ngoccamne/DAL_PDU/doc/site/code_architecture/index.html

- Code architecture

# Code architecture

This page describes how the current DAL_PDU firmware is layered, how data moves between modules, and which tasks own which state. It describes the code under PDU/firmware/DAL_PDU/DAL_PDU/. For the short overview see Current firmware architecture; for the scheduler internals see Scheduler design.

## 1. Layers

The source tree is organised in six numbered layers. Lower numbers are closer to the application; the M prefix is only a directory convention, not a build boundary.

Layer | Path | Contents | Depends on
M0 Application | src/dev/M0_App/ | Startup (app_main), console, heartbeat LED, power/TRANS, power monitor, watchdog supervision, Modbus register callbacks | M1, M2, M4
M1 System | src/dev/M1_Sys/ | Scheduler (task and soft-timer service), CommandLine (parser, command table, command handlers), SystemData (shared status records) | M2, M4
M2 Board support | src/dev/M2_BSP/ | Pin map (dal_pdu_board.h), UART ownership, timer ISR, I2C, power GPIO, watchdog pins, LED, Modbus port, TPS55287/PAC1934/24C04 board bindings | M3, M4
M3 Driver | src/dev/M3_Driver/ | Component/ holds the AVR UART, software UART, I2C, and GPIO drivers. Devices/ holds the TPS55287, PAC1934, and 24C04 chip drivers | M4, AVR headers
M4 Middleware | src/dev/M4_MiddleWare/ | Byte FIFO, printf hook, FreeMODBUS (submodule) | AVR headers only

### 1.1 Dependency rules as implemented

The intended direction is strictly downward. The code does not fully keep that promise:

Observed dependency | Where | Assessment
M0 calls M2 directly (power GPIO, TPS55287, PAC1934, watchdog pins) | app_power.c, app_modbus.c, app_power_monitor.c, app_watchdog.c | Expected. M0 is the only caller that sequences the board.
M1 command handlers call M2 BSP | command_tps55287.c, command_pac1934.c, command_i2c.c, command_eeprom.c | Expected for maintenance commands, but it means host tests must mock BSP.
M2 owns the TPS55287 record | bsp_tps55287.c keeps BSP_TPS55287_Status, read by M0 and M1 through BSP_TPS55287_GetStatus() | Resolved 2026-10-06. M2 no longer writes into M1. The record is no longer in SystemData.
M0 Modbus callbacks call M0 app_power and M1 SystemData | app_modbus.c | Expected; both are in the application layer.

Shared state lives in exactly one place. Most of it is in SystemData. The TPS55287 record is in its BSP module, which is the only writer. Commands, tasks, and Modbus callbacks read these records. No layer keeps a second copy of the same fact.

## 2. Module dependency view

flowchart TB
  subgraph M0["M0 Application"]
    MAIN["app_main"]
    CON["app_console"]
    HB["app_heartbeat"]
    PWR["app_power"]
    PMON["app_power_monitor"]
    WDG["app_watchdog"]
    MB["app_modbus"]
  end
  subgraph M1["M1 System"]
    SCH["Scheduler"]
    CMD["CommandLine"]
    SD["SystemData"]
  end
  subgraph M2["M2 Board support"]
    BTIM["bsp_timer"]
    BUART["bsp_uart"]
    BI2C["bsp_i2c"]
    BPWR["bsp_power"]
    BWD["bsp_watchdog"]
    BMB["bsp_modbus"]
    BTPS["bsp_tps55287"]
    BPAC["bsp_pac1934"]
    BEE["bsp_eeprom"]
  end
  subgraph M4["M4 Middleware"]
    FIFO["FIFO"]
    FMB["FreeMODBUS"]
  end

  MAIN --> SCH
  MAIN --> BTIM
  CON --> CMD
  CON --> BUART
  CON --> FIFO
  CON --> WDG
  HB --> SD
  HB --> SCH
  PWR --> SD
  PWR --> BPWR
  PWR --> BTPS
  PMON --> SD
  PMON --> BPAC
  WDG --> SD
  WDG --> BWD
  MB --> FMB
  MB --> SD
  MB --> PWR
  MB --> BTPS
  CMD --> BTPS
  CMD --> BPAC
  CMD --> BI2C
  CMD --> BEE
  CMD --> SD
  BTIM --> SCH
  BTPS --> SD
  BMB --> FMB
  BUART --> FIFO

## 3. Startup sequence

main() calls APP_Main(). Initialization runs with interrupts disabled. Interrupts are enabled only after the scheduler has its task table and Timer0 is running.

sequenceDiagram
  participant M as main
  participant A as APP_Initialize
  participant S as Scheduler
  participant T as Timer0
  participant L as Main loop
  M->>A: APP_Main()
  A->>A: EEPROM init, UART board init, startup banners
  A->>A: SystemData_Init, AppPower_Init, I2C init
  A->>S: SCH_InitializeTaskTable(5 tasks)
  A->>A: Watchdog, console, heartbeat, Modbus init
  A->>A: AppWatchdog_Start (requires all clients registered)
  A->>T: BSP_Timer_Init1ms
  A->>S: SCH_StartScheduler
  A-->>M: true
  M->>M: sei()
  loop forever
    L->>S: SCH_HandleScheduledTask
    L->>L: APP_ModbusTask every 5 ms (AppModbus_Update, two eMBPoll calls)
  end

If any step fails, APP_Initialize closes the UARTs and stops the scheduler, and most failure branches also call BSP_Watchdog_Inhibit(). APP_Main then spins with interrupts disabled. The external TPL5010 watchdog is then the only recovery path, which resets the MCU and retries startup.

## 4. Task inventory

These six tasks are the only scheduled work. Dispatch order is table index order, from app_main.c. All run from the main loop, never from an ISR.

Index | Task | Period | First run (phase) | Reads | Writes
0 | AppConsole_Run | 10 ms | 0 ms | UART0 and console RX FIFOs | Console sessions, response FIFO, TX FIFOs, watchdog check-in; runs one parsed command per call
1 | AppHeartbeat_Update | 20 ms | 0 ms | Operating mode, SystemData heartbeat timing and enable | LED pattern for the mode, soft timer SCH_TIM_LED, watchdog check-in
2 | AppPower_Update | 6 ms | 3 ms | PC4 and PC0 fault inputs, TRANS state | TRANS GPIO and VOUT disable on fault, SystemData power status
3 | AppPowerMonitor_Update | 1000 ms | 0 ms | PAC1934 snapshot | SystemData power monitor status
4 | AppWatchdog_Update | 10 ms | 0 ms | Client check-in times, WAKE pin (PB5) | DONE pin (PB6), wake status, fault latch
5 | AppTemperature_Update | 1000 ms | 0 ms | ADC channel 1 (PF1) through BSP_NTC_ReadTenthsC | SystemData temperature status
6 | APP_ModbusTask (AppModbus_Update) | 5 ms | 0 ms | USART1 RX frame and event queue, SystemData and TPS55287 records through the Modbus callbacks | eMBPoll replies, watchdog check-in

The 6 ms power task and the 10 ms console task are not synchronized; the 3 ms phase keeps the first power check away from the first console pass.

Two more pieces of work run every main-loop pass, outside the table:

- AppModbus_Update() calls eMBPoll() twice, from the 5 ms task. A request needs two polls. This services the USART1 RX/TX event queue and the Modbus callbacks, which read and write SystemData, call AppPower_SetTrans(), and call the TPS55287 BSP.
- The printf hook _putchar writes into the active console response owner, if one is set.

## 5. Data flows

### 5.1 Tick to task

flowchart LR
  T0["Timer0 compare ISR\n1 ms"] --> RT["SCH_RunSystemTickTimer"]
  RT --> EL["Each enabled task:\nelapsed_ms++\nready = TRUE when due"]
  RT --> ST["Soft timers --"]
  ML["Main loop\nSCH_HandleScheduledTask"] --> CL["Read and clear ready\nunder ATOMIC_BLOCK"]
  CL --> RUN["Call task function\nin index order"]

The ISR never calls a task. It only sets ready. A task that is due twice before it runs runs once (see Scheduler design).

### 5.2 Console command

flowchart LR
  RX0["USART0 RX ISR\nUART0 port"] --> RXF["RX FIFO"]
  RXS["Timer2 soft UART\nconsole port"] --> RXF
  RXF --> LINE["AppConsole_ReadSession\nassemble line, echo"]
  LINE --> EX["AppConsole_Execute\nCmdLineProcess"]
  EX --> H["Command handler\nfor one table row"]
  H --> W["Command_OutputString\n-> AppConsole_WriteResponse"]
  W --> RSP["Shared response FIFO\n256 bytes"]
  RSP --> FL["AppConsole_FlushOutput"]
  FL --> TXW["BSP_UART_Write"]
  TXW --> TXF["TX FIFO\nUART0 UDRE ISR or Timer2 ISR"]

Only one port owns the response FIFO at a time, set when a command starts executing. A second port's line waits in its session until the owner finishes sending. help streams one table entry per pass through Command_ContinueOutput, so the 256-byte FIFO can drain between passes.

### 5.3 Modbus request

flowchart LR
  RX1["USART1 RX ISR"] --> PORT["FreeMODBUS port queue"]
  T1["Timer1 compare ISR\nRTU silence"] --> PORT
  PORT --> POLL["eMBPoll in the 5 ms Modbus task"]
  POLL --> CB["eMBReg*CB callbacks\nin app_modbus.c"]
  CB --> SD["SystemData"]
  CB --> PW["AppPower_SetTrans"]
  CB --> TPS["BSP_TPS55287 set/get"]
  POLL --> TX1["USART1 TX ISR\nRS485 direction on PD5"]

### 5.4 Power fault response

1. AppPower_Update runs every 6 ms and reads PC4 and PC0.
2. If either fault is active while TRANS is on, it disables VOUT first, then drops TRANS, and latches the fault in internal EEPROM until it is cleared.
3. It publishes the new status to SystemData. Modbus and console trans get read that record.
4. A console or Modbus request to turn TRANS on re-checks both faults before enabling PC2, and returns TRANS fault if either is still active.

The mode (NORMAL, MANUAL, WARNING, or ERROR) is derived from the self-test, the fault latch, the manual request, and the PAC1934 status. See Mode state machine.

### 5.5 Telemetry

AppPowerMonitor_Update runs once per second. It calls BSP_PAC1934_ReadSnapshot and writes voltage, current, and power for four channels. The pac1934 console command reads the record, and does not trigger a fresh conversion itself. The TPS55287 record is refreshed by BSP calls in the command and Modbus paths, not by a periodic task. It lives in M2, so it is read through BSP_TPS55287_GetStatus().

### 5.6 Watchdog handshake

flowchart LR
  C1["Console task\ncheck-in"] --> WS["Watchdog state\nlast check-in per client"]
  C2["Heartbeat task\ncheck-in"] --> WS
  WS --> WU["AppWatchdog_Update\nevery 10 ms"]
  WU -->|"all clients fresh"| DONE["Pulse DONE high 100 ms\nPB6 to TPL5010"]
  WU -->|"client late or monitor late"| FLT["Fault latch\nstop DONE pulses"]
  FLT --> RST["TPL5010 resets MCU"]

The client timeout is 200 ms for both clients. The monitor timeout is also 200 ms. A fault latch is permanent until reset.

## 6. Shared state and who touches it

State | Owner | Writers | Readers | Concurrency rule
SystemData heartbeat, power, watchdog-wake, PAC1934, temperature records | M1 SystemData | Main-loop tasks, command handlers, Modbus callbacks | Main-loop tasks, commands, Modbus | No ISR touches these records. Single-context access.
TPS55287 record | M2 bsp_tps55287.c | The TPS55287 BSP calls, on the main loop | Main loop, command handlers, Modbus callbacks, AppSetpoint_Update through BSP_TPS55287_GetStatus() | Written only from the main loop. Single-context access.
Software clock | M0 app_clock | Main loop: time, Modbus callbacks (40040–40041), the event log, and a 1 s task that writes the 15-minute checkpoint | Main loop | Written only from the main loop. SCH_SystemTick supplies the elapsed time. Checkpoints go to internal EEPROM at 110–151 (a ring of 8).
Scheduler task table | M1 Scheduler | SCH_RunSystemTickTimer (ISR): elapsed_ms, ready. Main loop: enabled, ready cleared, and period changes | SCH_HandleScheduledTask | Main-loop writes use ATOMIC_BLOCK. ISR writes rely on the ISR being the only writer of elapsed_ms and ready set.
Scheduler soft timers | M1 Scheduler | Main loop (SCH_TIM_Start) and ISR (decrement) | Main loop (SCH_TIM_isCompleted) | Start and read are atomic. Decrement is ISR-only.
UART and console FIFOs | M4 FIFO, M2 UART | UART ISRs, Timer2 ISR, and main-loop writes | Main loop, ISRs | fifo.h states that Push, Pop, Count, and Clear are atomic on AVR. The response spool is used only from the main loop.
Console response spool and session state | M0 app_console | Main loop only | Main loop only | No ISR access.
Modbus port state | FreeMODBUS | USART1 and Timer1 ISRs, then eMBPoll in the 5 ms Modbus task | eMBPoll | Standard FreeMODBUS port contract.

Everything an ISR touches is either a volatile scalar, an atomically-read counter, or a FIFO designed for one producer and one consumer. The main loop owns all application state.

## 7. Known gaps in the architecture

- Priorities. Tasks run in table order. A long task delays every later task in the same pass. Nothing measures execution time. See the scheduler design.
- Layer inversion: resolved. bsp_tps55287.c owns its record, so M2 no longer calls into M1. The record is read through BSP_TPS55287_GetStatus(). The other records are still written by M0 modules, which is the expected direction.
- Command and BSP coupling. Command handlers call BSP directly, so the command tests need the BSP mocked. This is acceptable for maintenance commands but not for future user-facing commands.
- Duplicate overview. Current firmware architecture and this page cover the same layers. Keep the overview short and point it here for detail.

Previous Next

Built with MkDocs (https://www.mkdocs.org/) using a theme (https://github.com/readthedocs/sphinx_rtd_theme) provided by Read the Docs (https://readthedocs.org).

« Previous Next »
