ngoccamne/DAL_PDU/ref/schematic/DAL_PDU.pdf

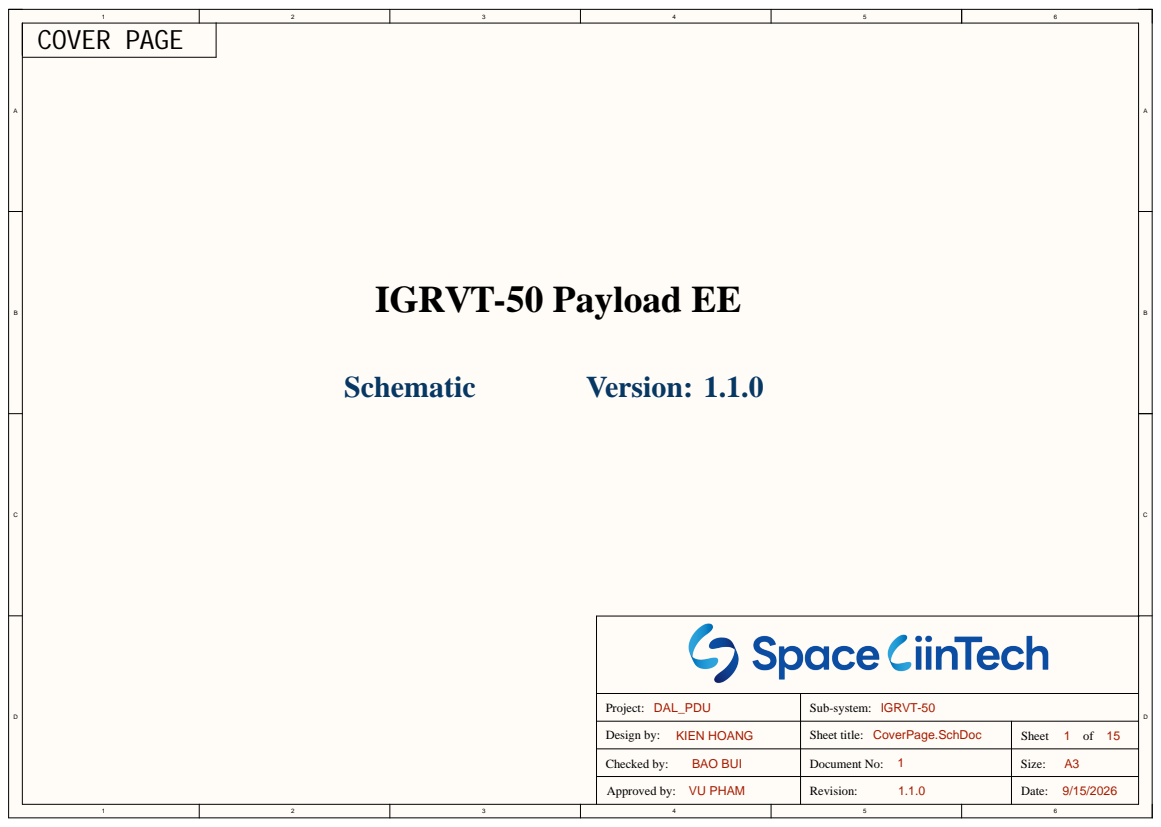
[picture p1: page 1]

Project: DAL_PDU | Sub-system: IGRVT-50

Design by: KIEN HOANG | Sheet title: CoverPage.SchDoc | Sheet 1 of 15

Checked by: BAO BUI | Document No: 1 | Size: A3

Approved by: VU PHAM | 1.1.0 Revision: | Date: 9/15/2026

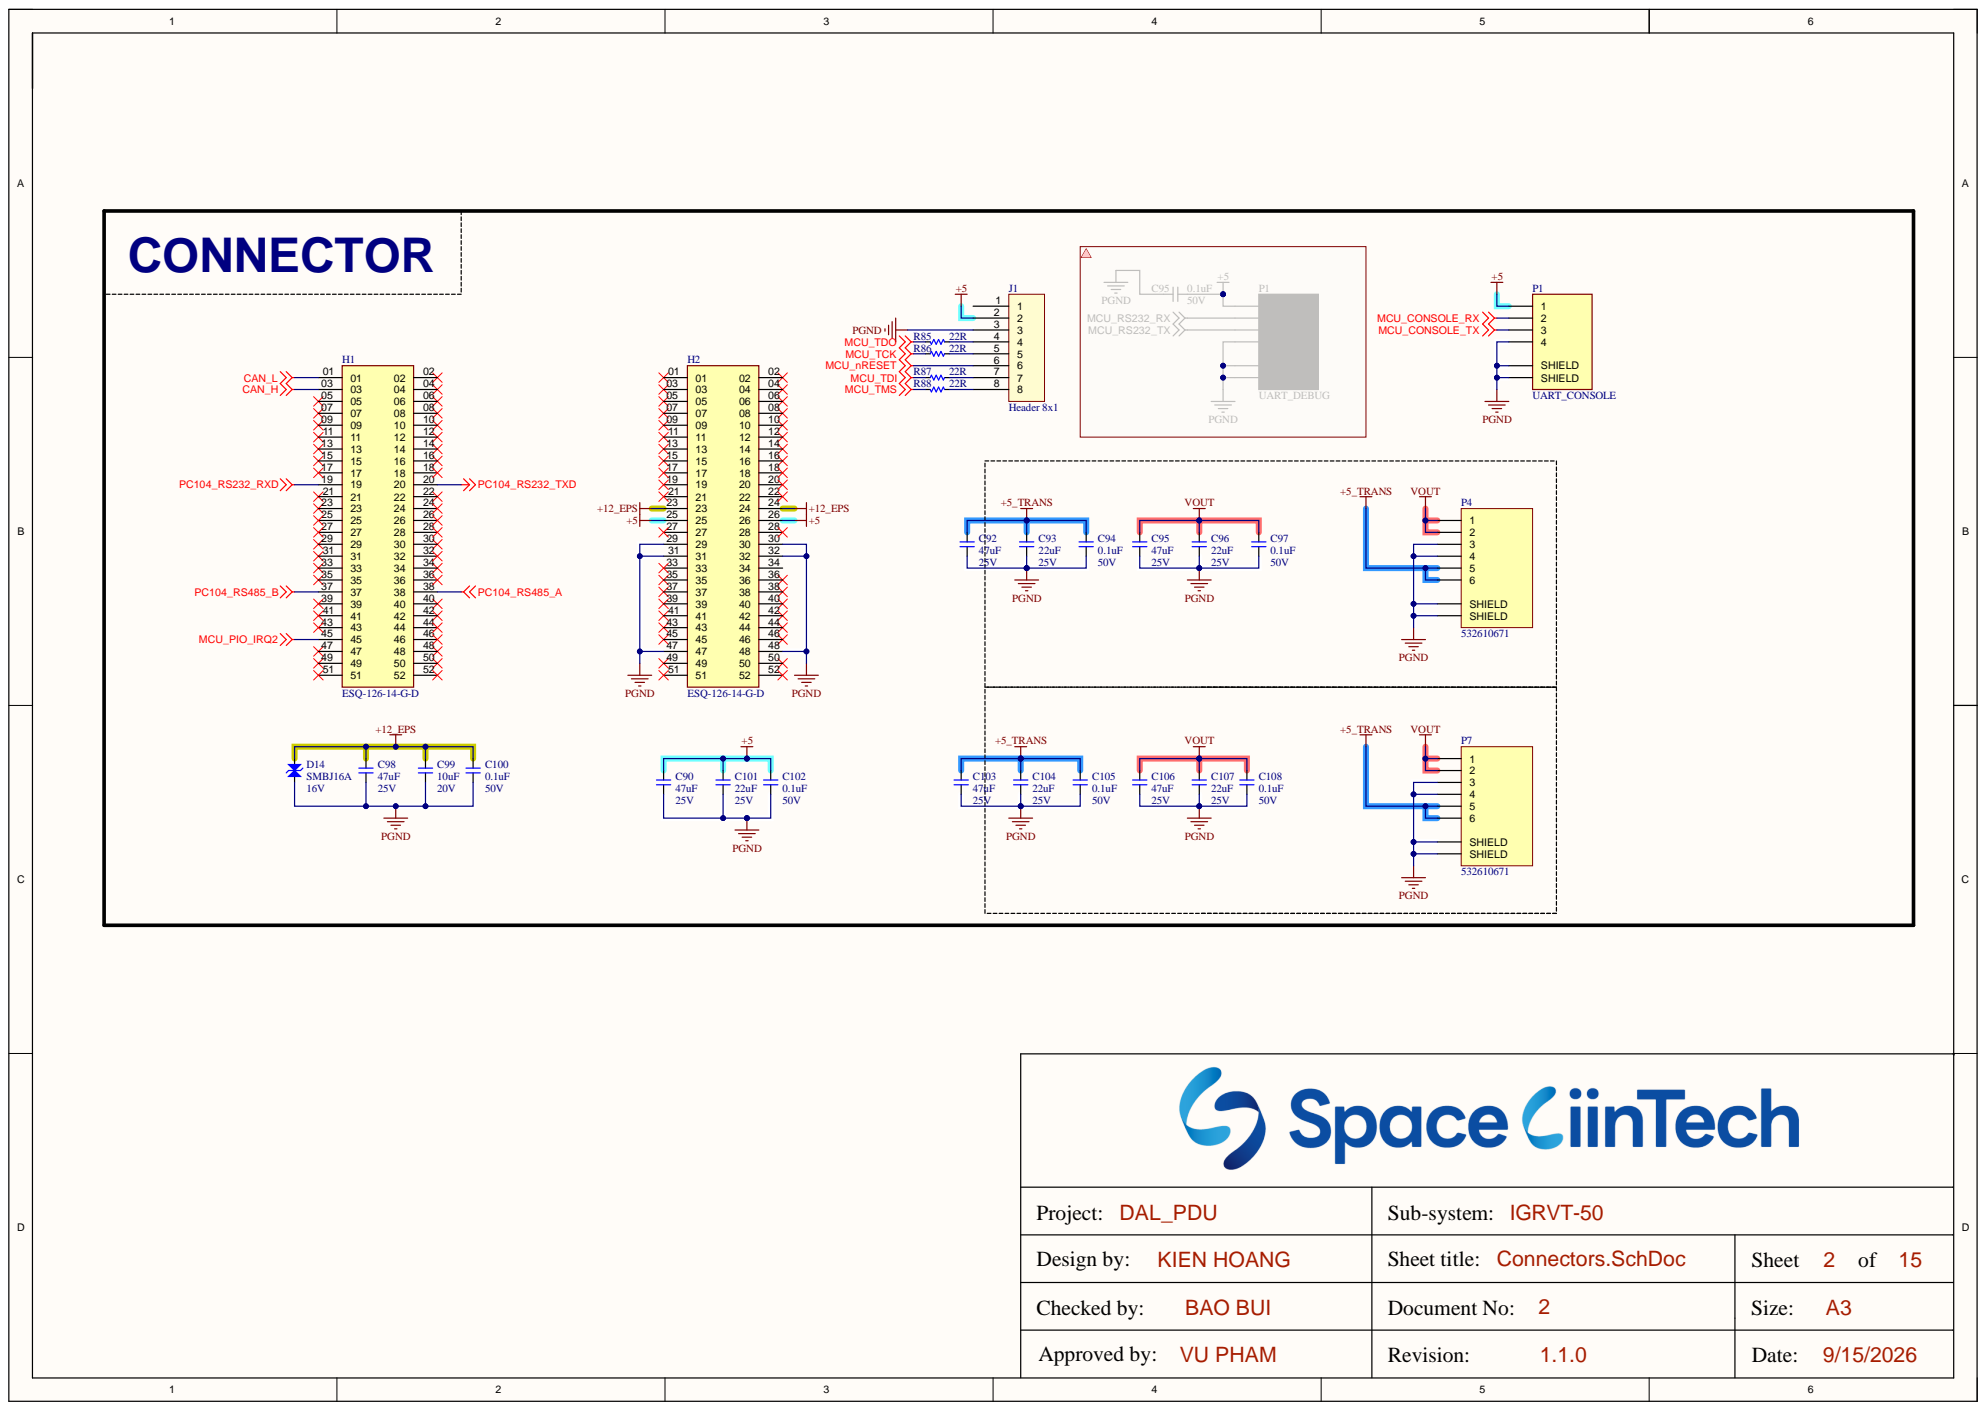
[picture p2: page 2]

Project: DAL_PDU | Sub-system: IGRVT-50

Design by: KIEN HOANG | Sheet title: Connectors.SchDoc | Sheet 2 of 15

Checked by: BAO BUI | Document No: 2 | Size: A3

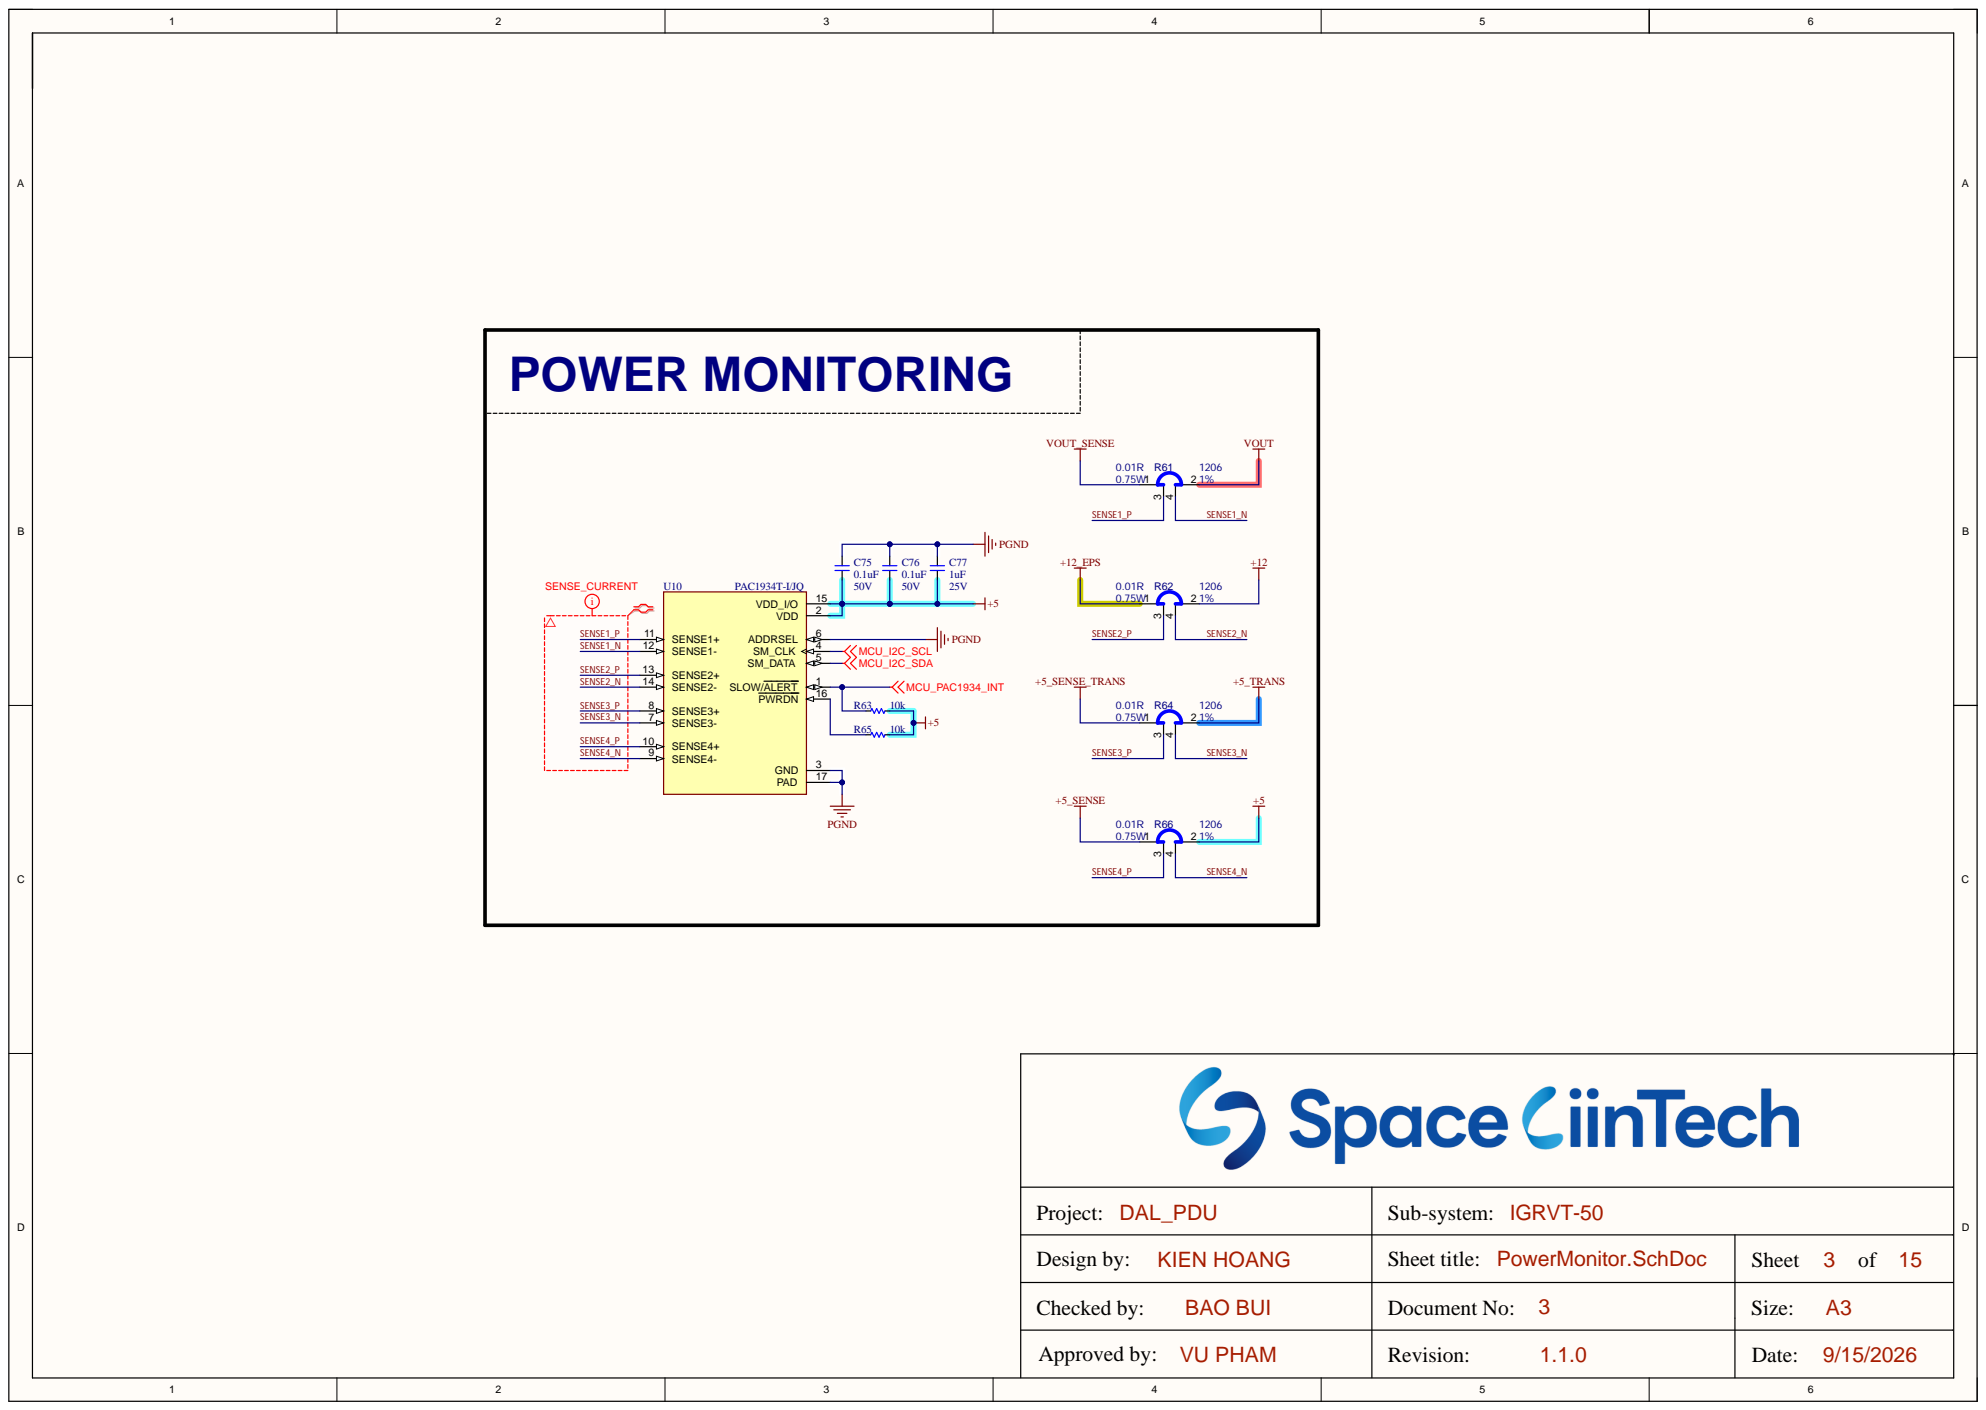
[picture p3: page 3]

Project : DAL_PDU | Sub-system : IGRVT-50

Design by: KIEN HOANG | Sheet title: PowerMonitor.SchDoc | Sheet 3 of 15

Checked by: BAO BUI | Document No: 1.1.0 3 | Size: A3

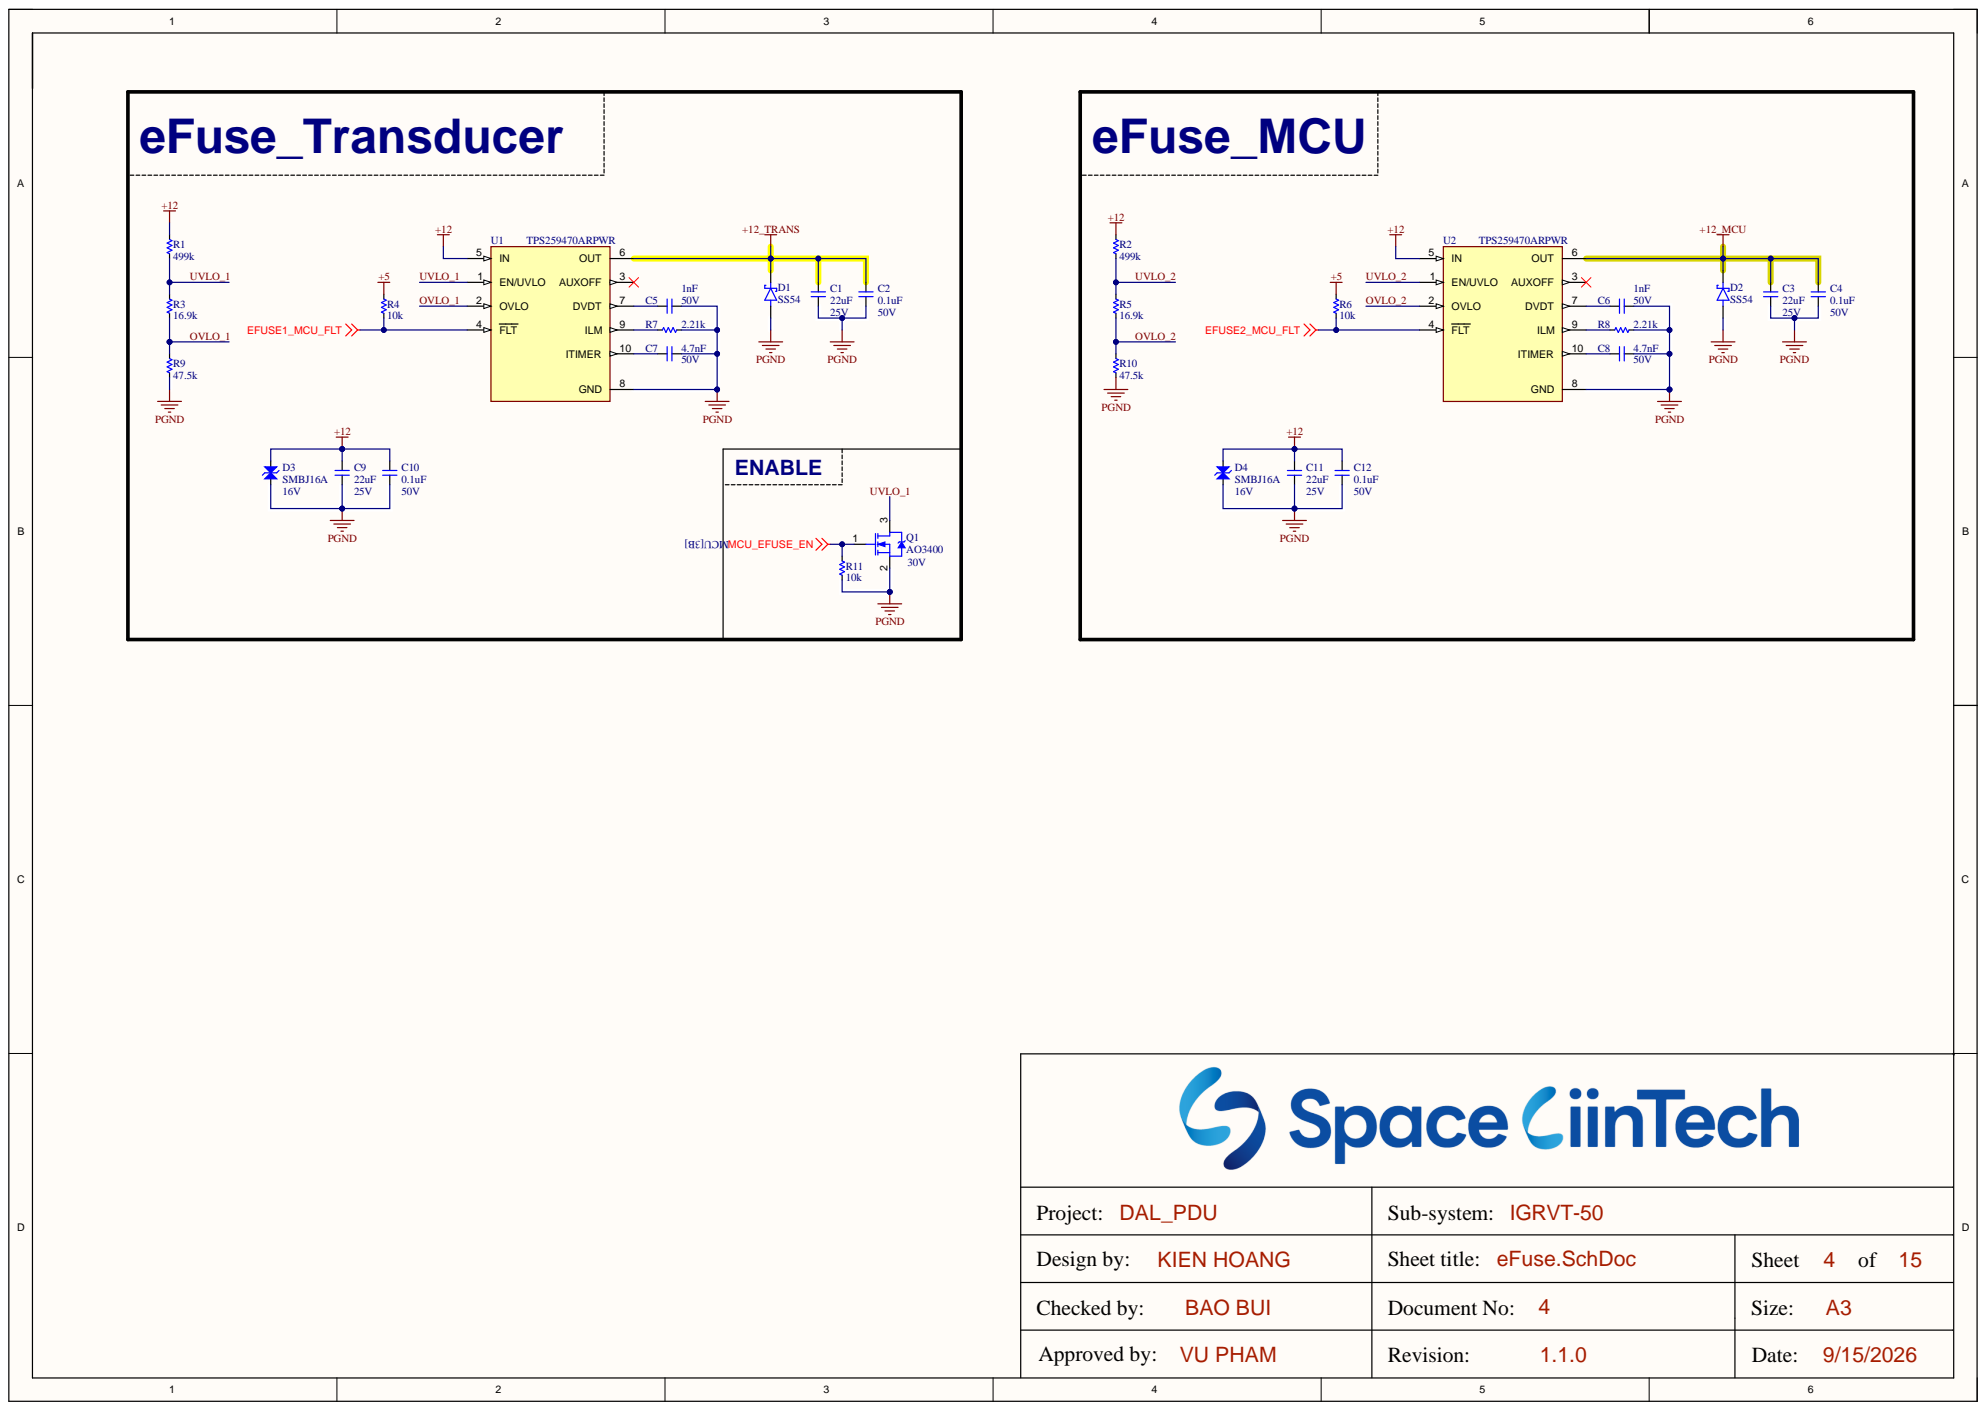
[picture p4: page 4]

Project : DAL_PDU | Sub-system : IGRVT-50

Design by: KIEN HOANG | Sheet title: eFuse.SchDoc | Sheet 4 of 15

Checked by: BAO BUI | Document No: 1.1.0 4 | Size: A3

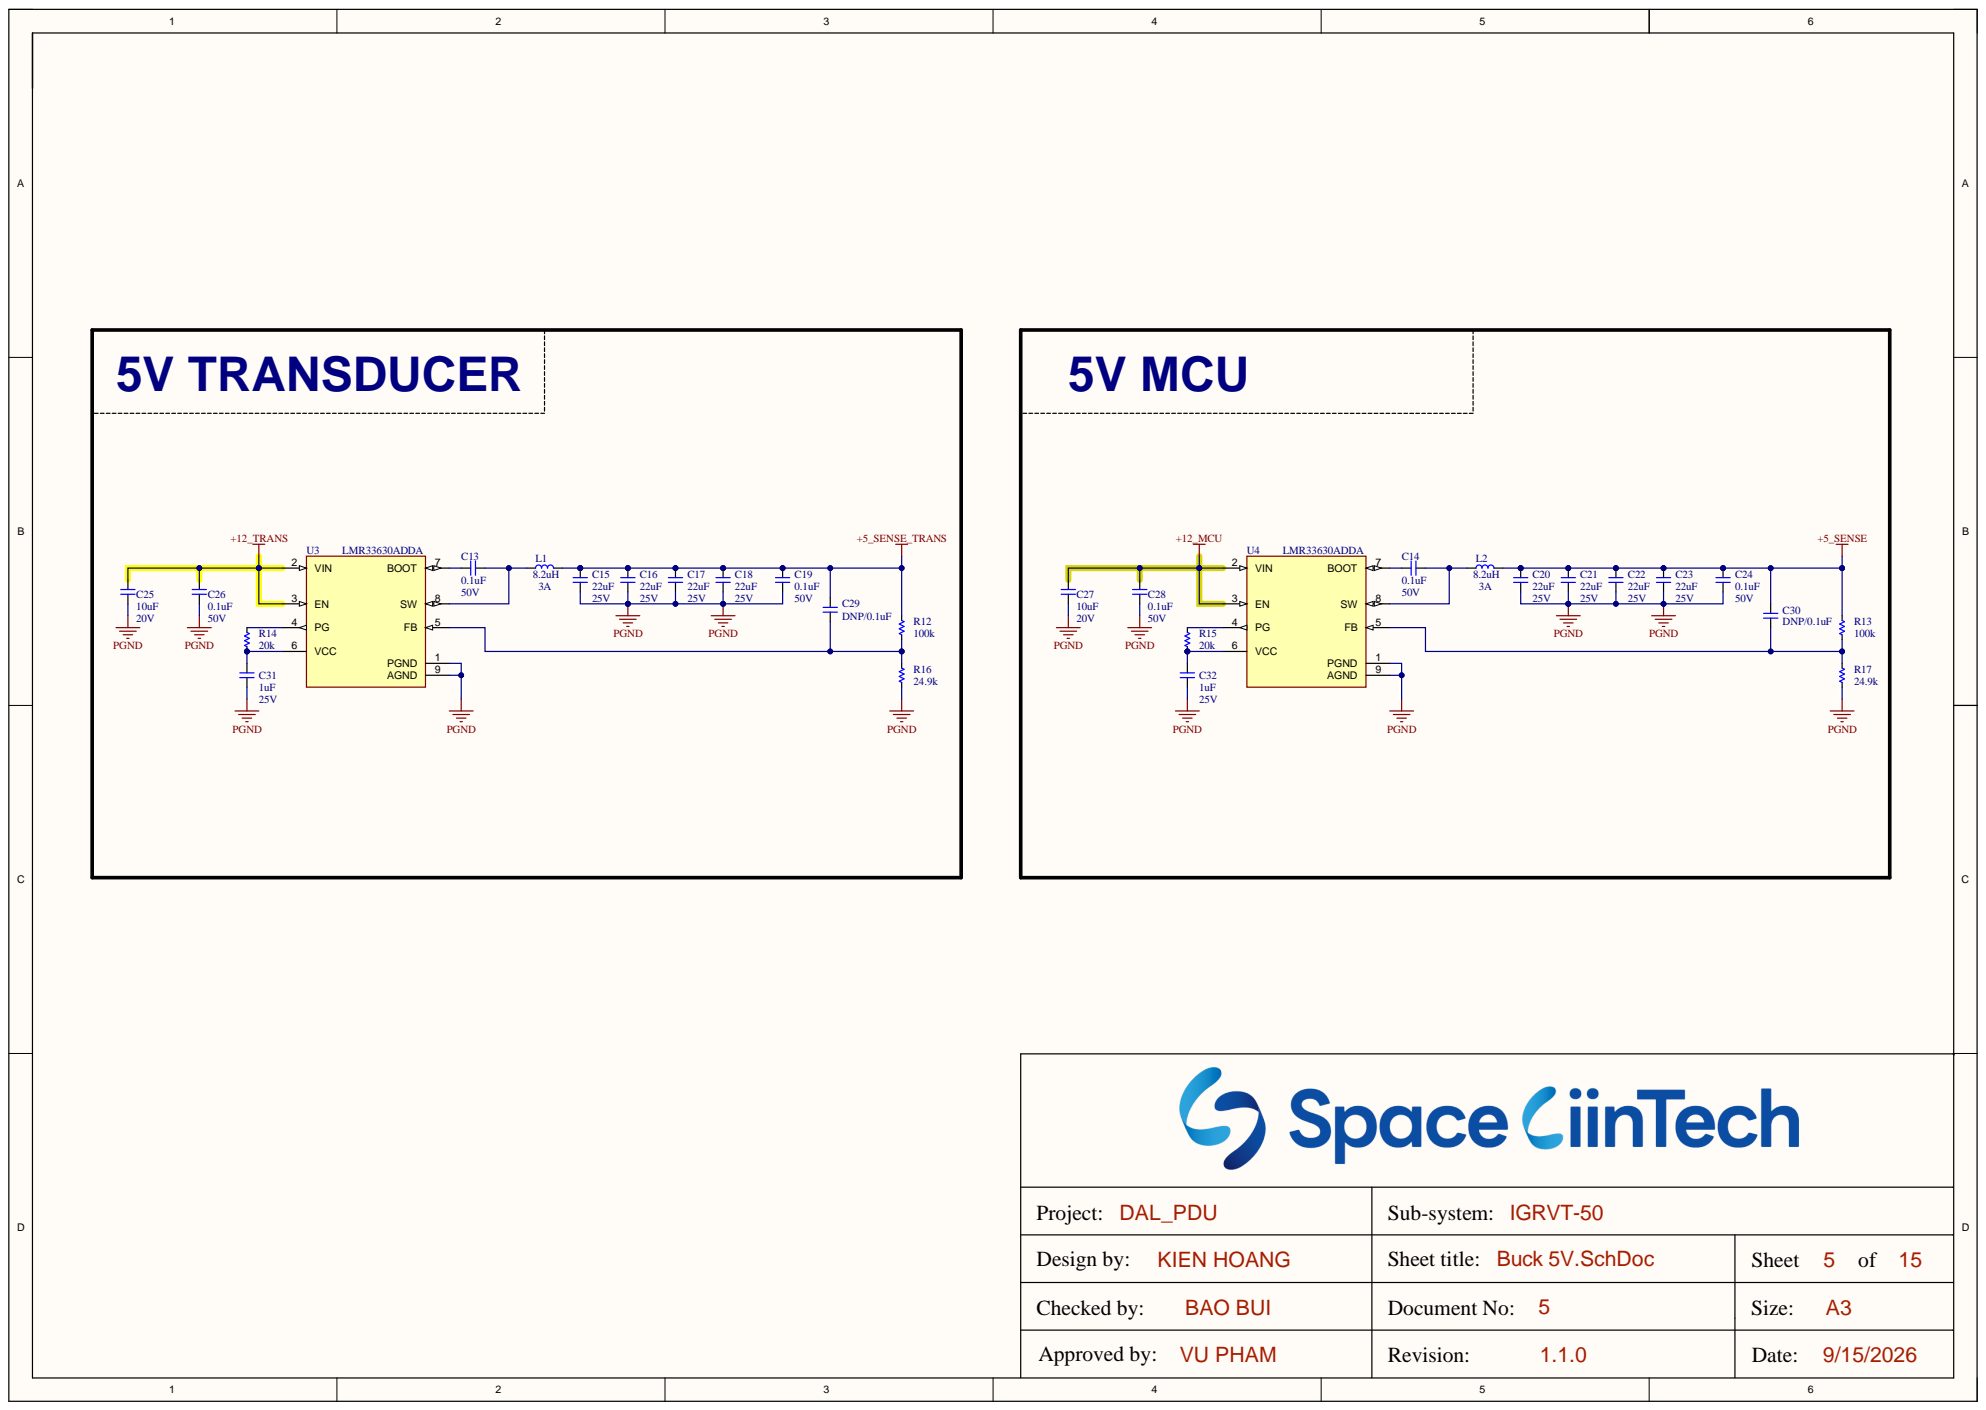
[picture p5: page 5]

Project : DAL_PDU | Sub-system : IGRVT-50

Design by: KIEN HOANG | Sheet title: Buck 5V.SchDoc | Sheet 5 of 15

Checked by: BAO BUI | Document No: 1.1.0 5 | Size: A3

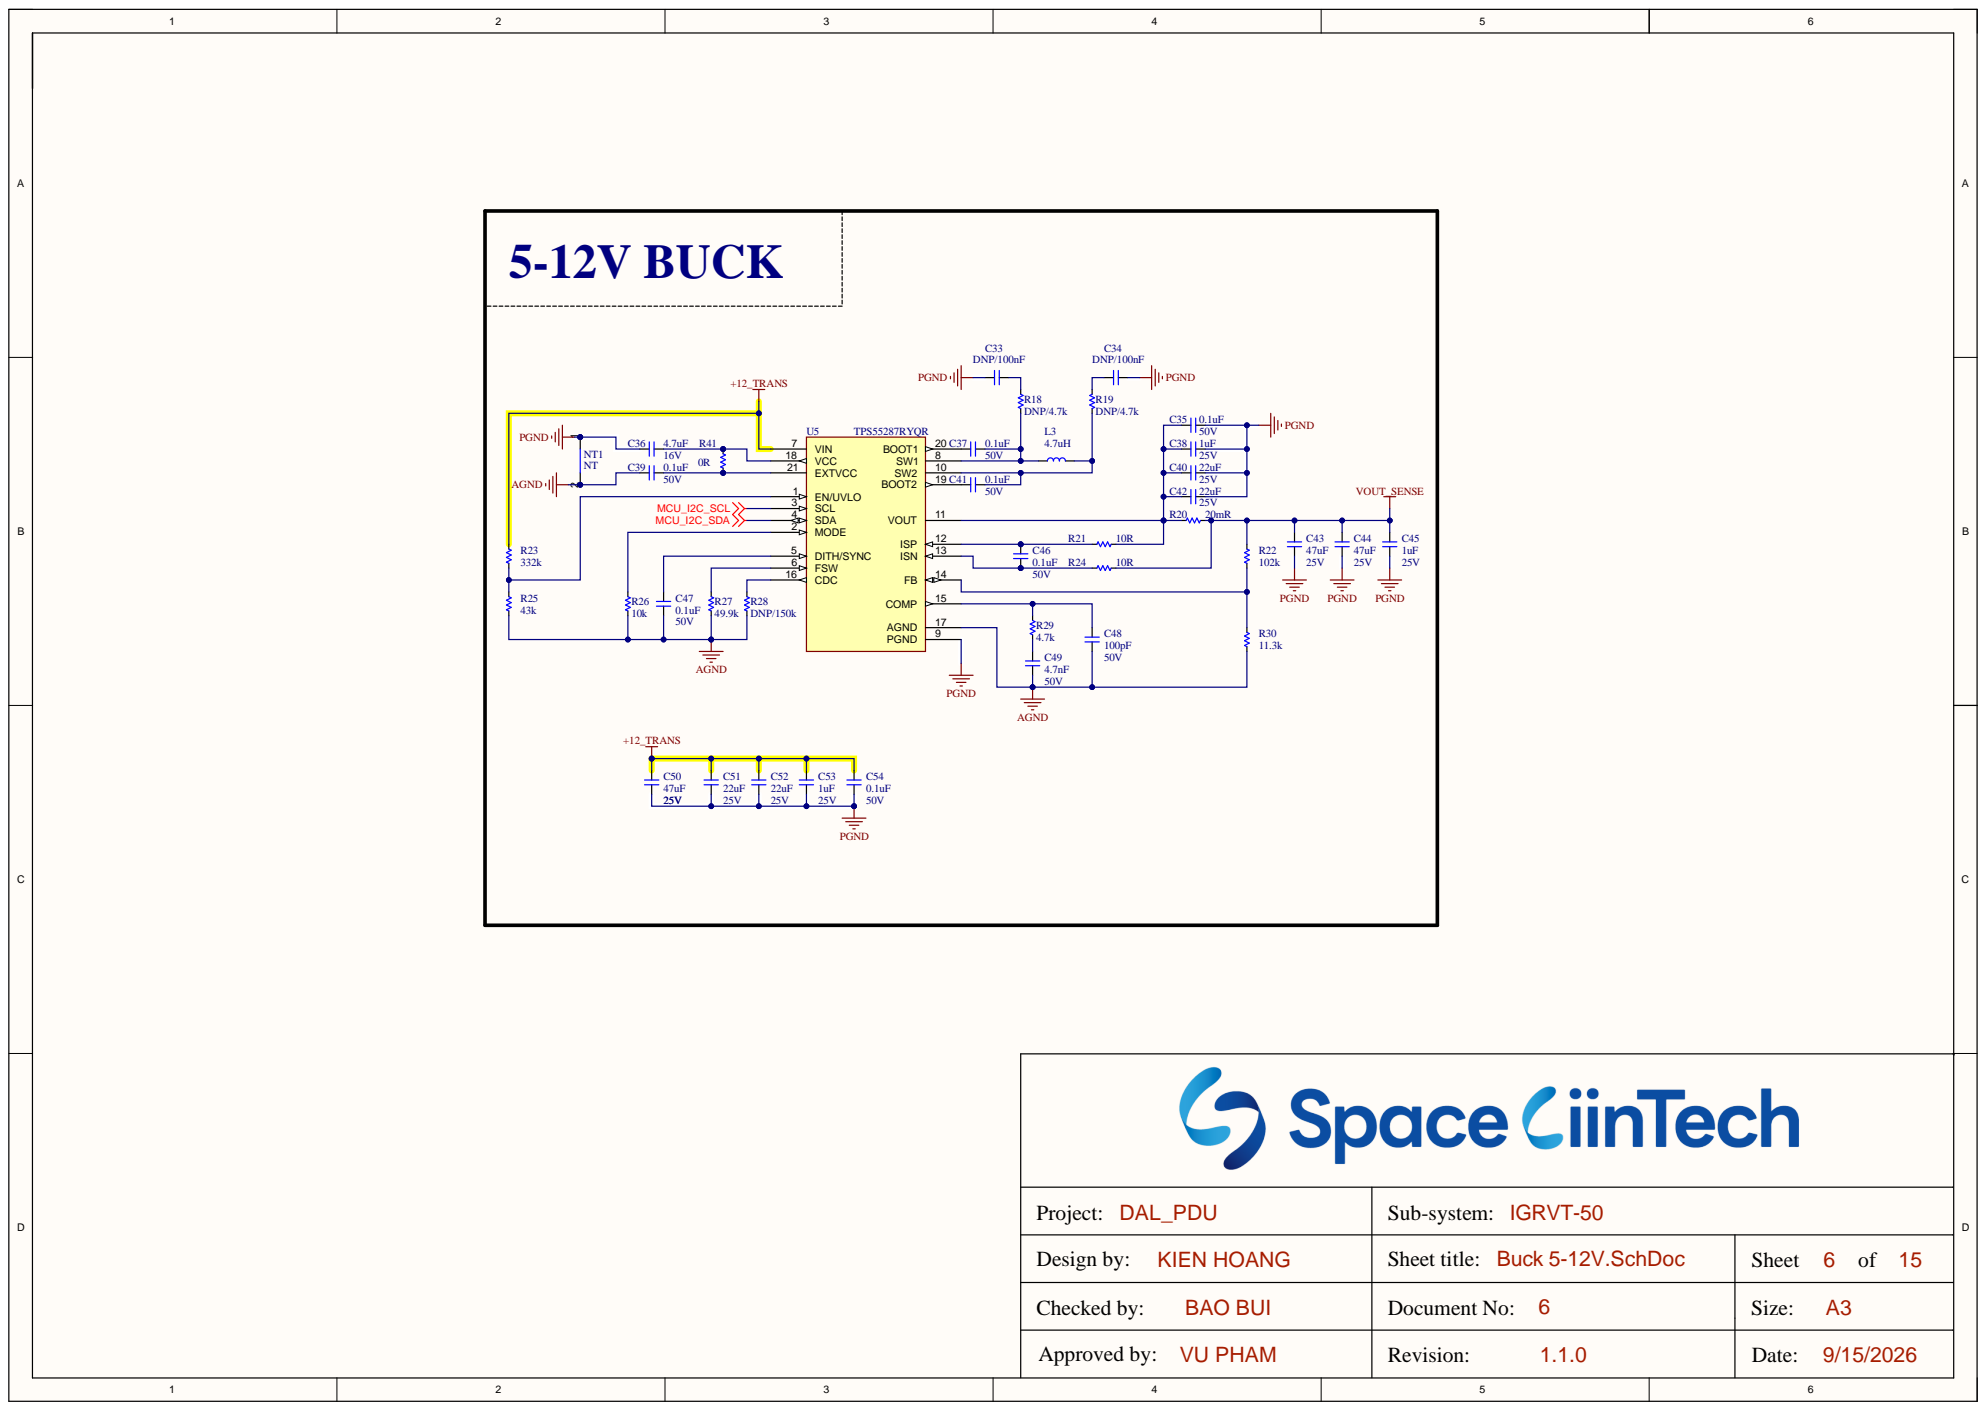
[picture p6: page 6]

DITH/SYNC 5
FSW 6 | 0.1uF R24
CDC 16 | 50V

Project: DAL_PDU | Sub-system: IGRVT-50

Design by: KIEN HOANG | Sheet title: Buck 5-12V.SchDoc | Sheet 6 of 15

Checked by: BAO BUI | Document No: 6 | Size: A3

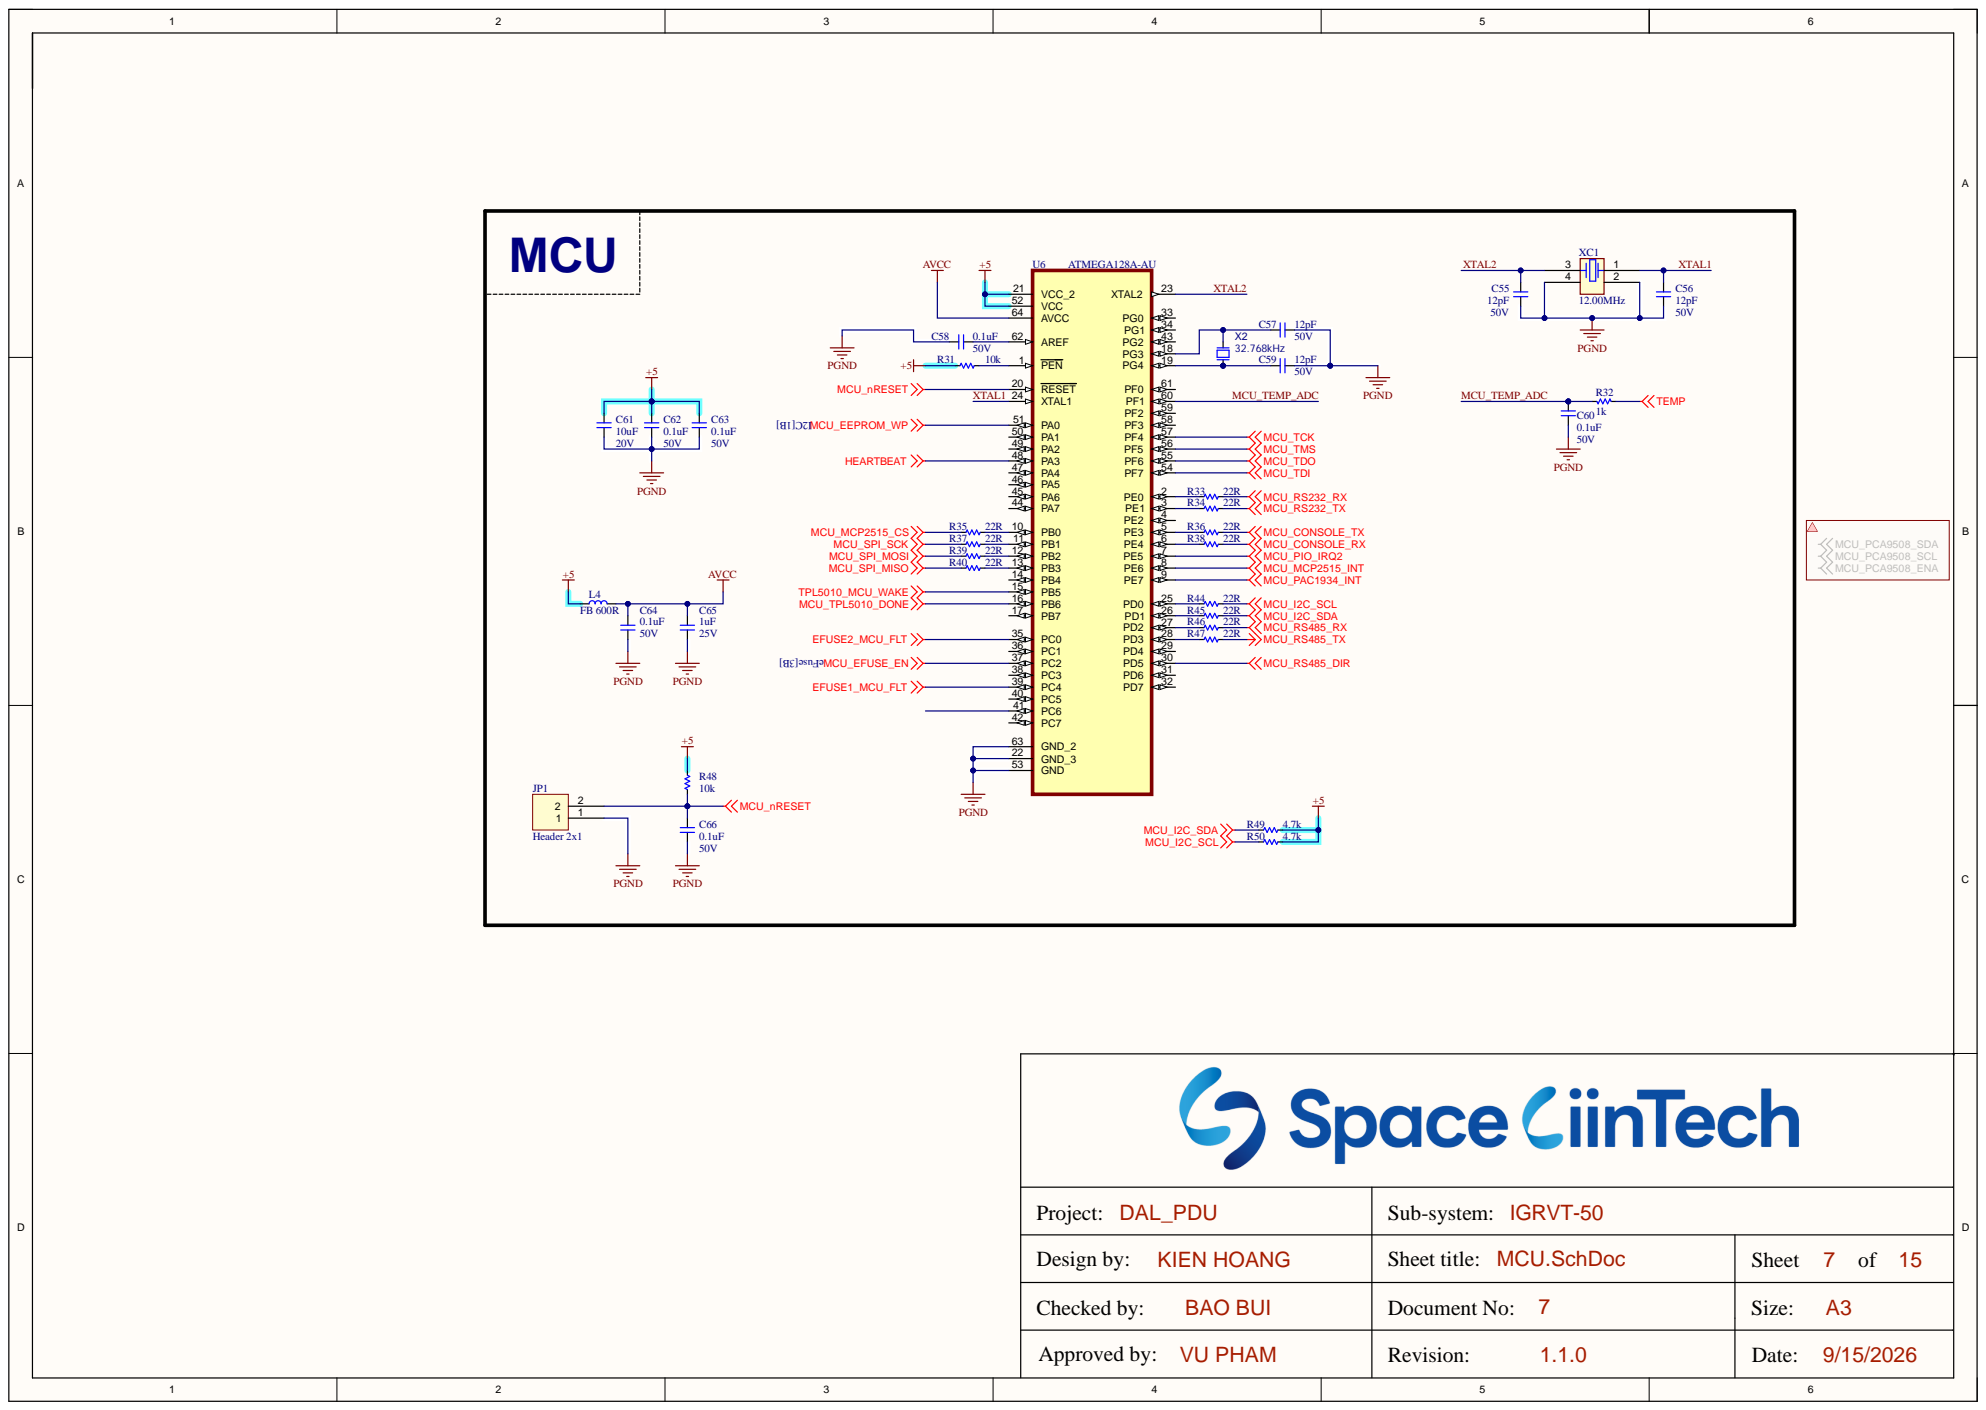
[picture p7: page 7]

2 2
5 3

Project : DAL_PDU | Sub-system : IGRVT-50

Design by: KIEN HOANG | Sheet title: MCU.SchDoc | Sheet 7 of 15

Checked by: BAO BUI | Document No: 1.1.0 7 | Size: A3

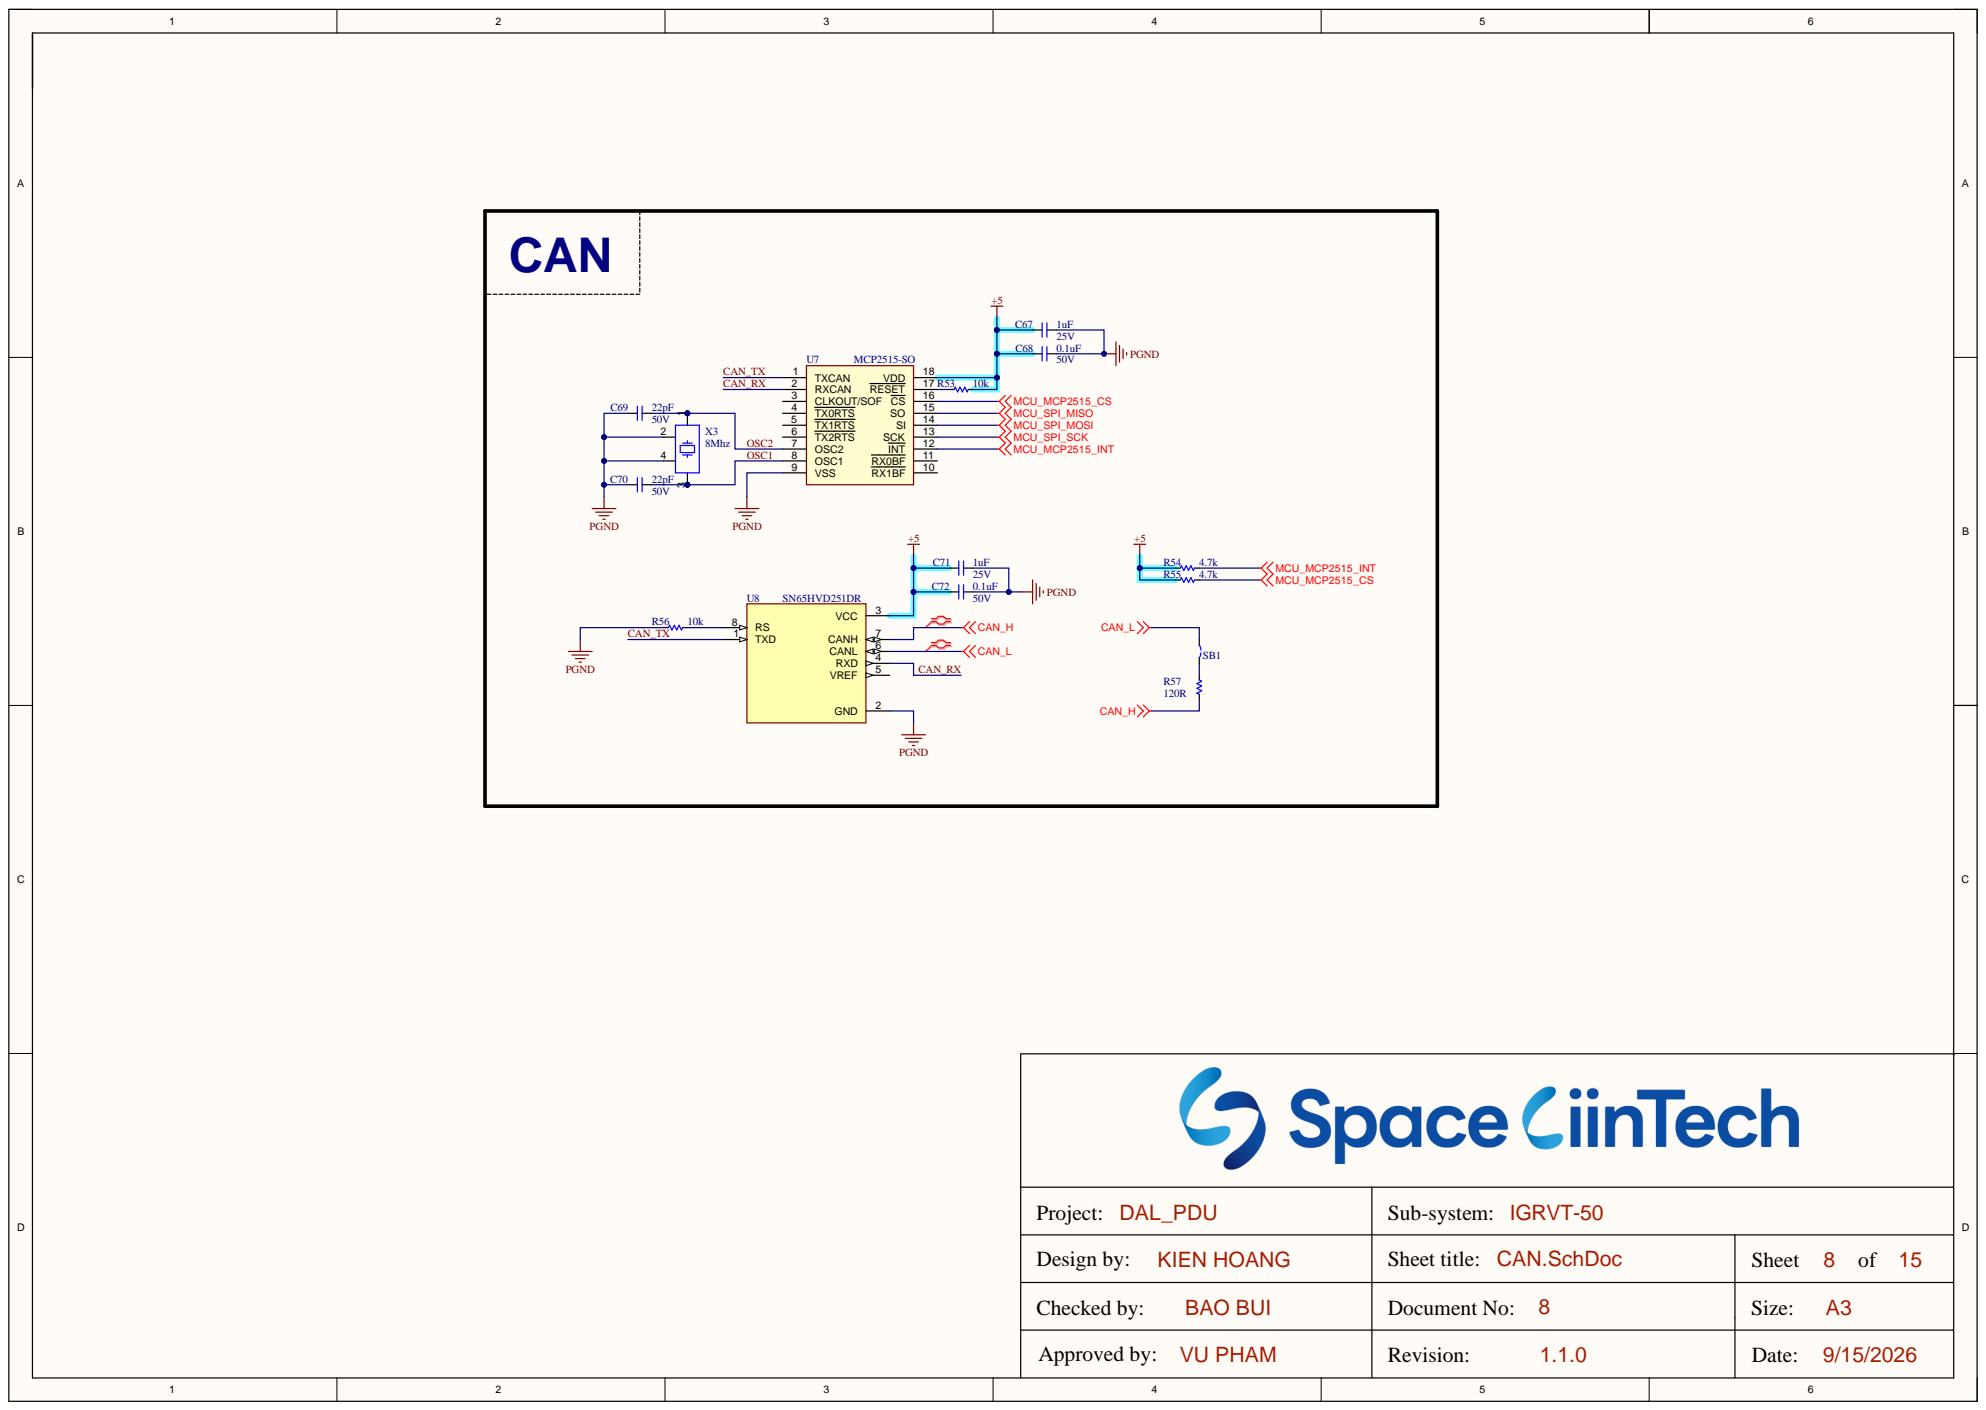
[picture p8: page 8]

Project: DAL_PDU | Sub-system: IGRVT-50

Design by: KIEN HOANG | Sheet title: CAN.SchDoc | Sheet 8 of 15

Checked by: BAO BUI | Document No: 8 | Size: A3

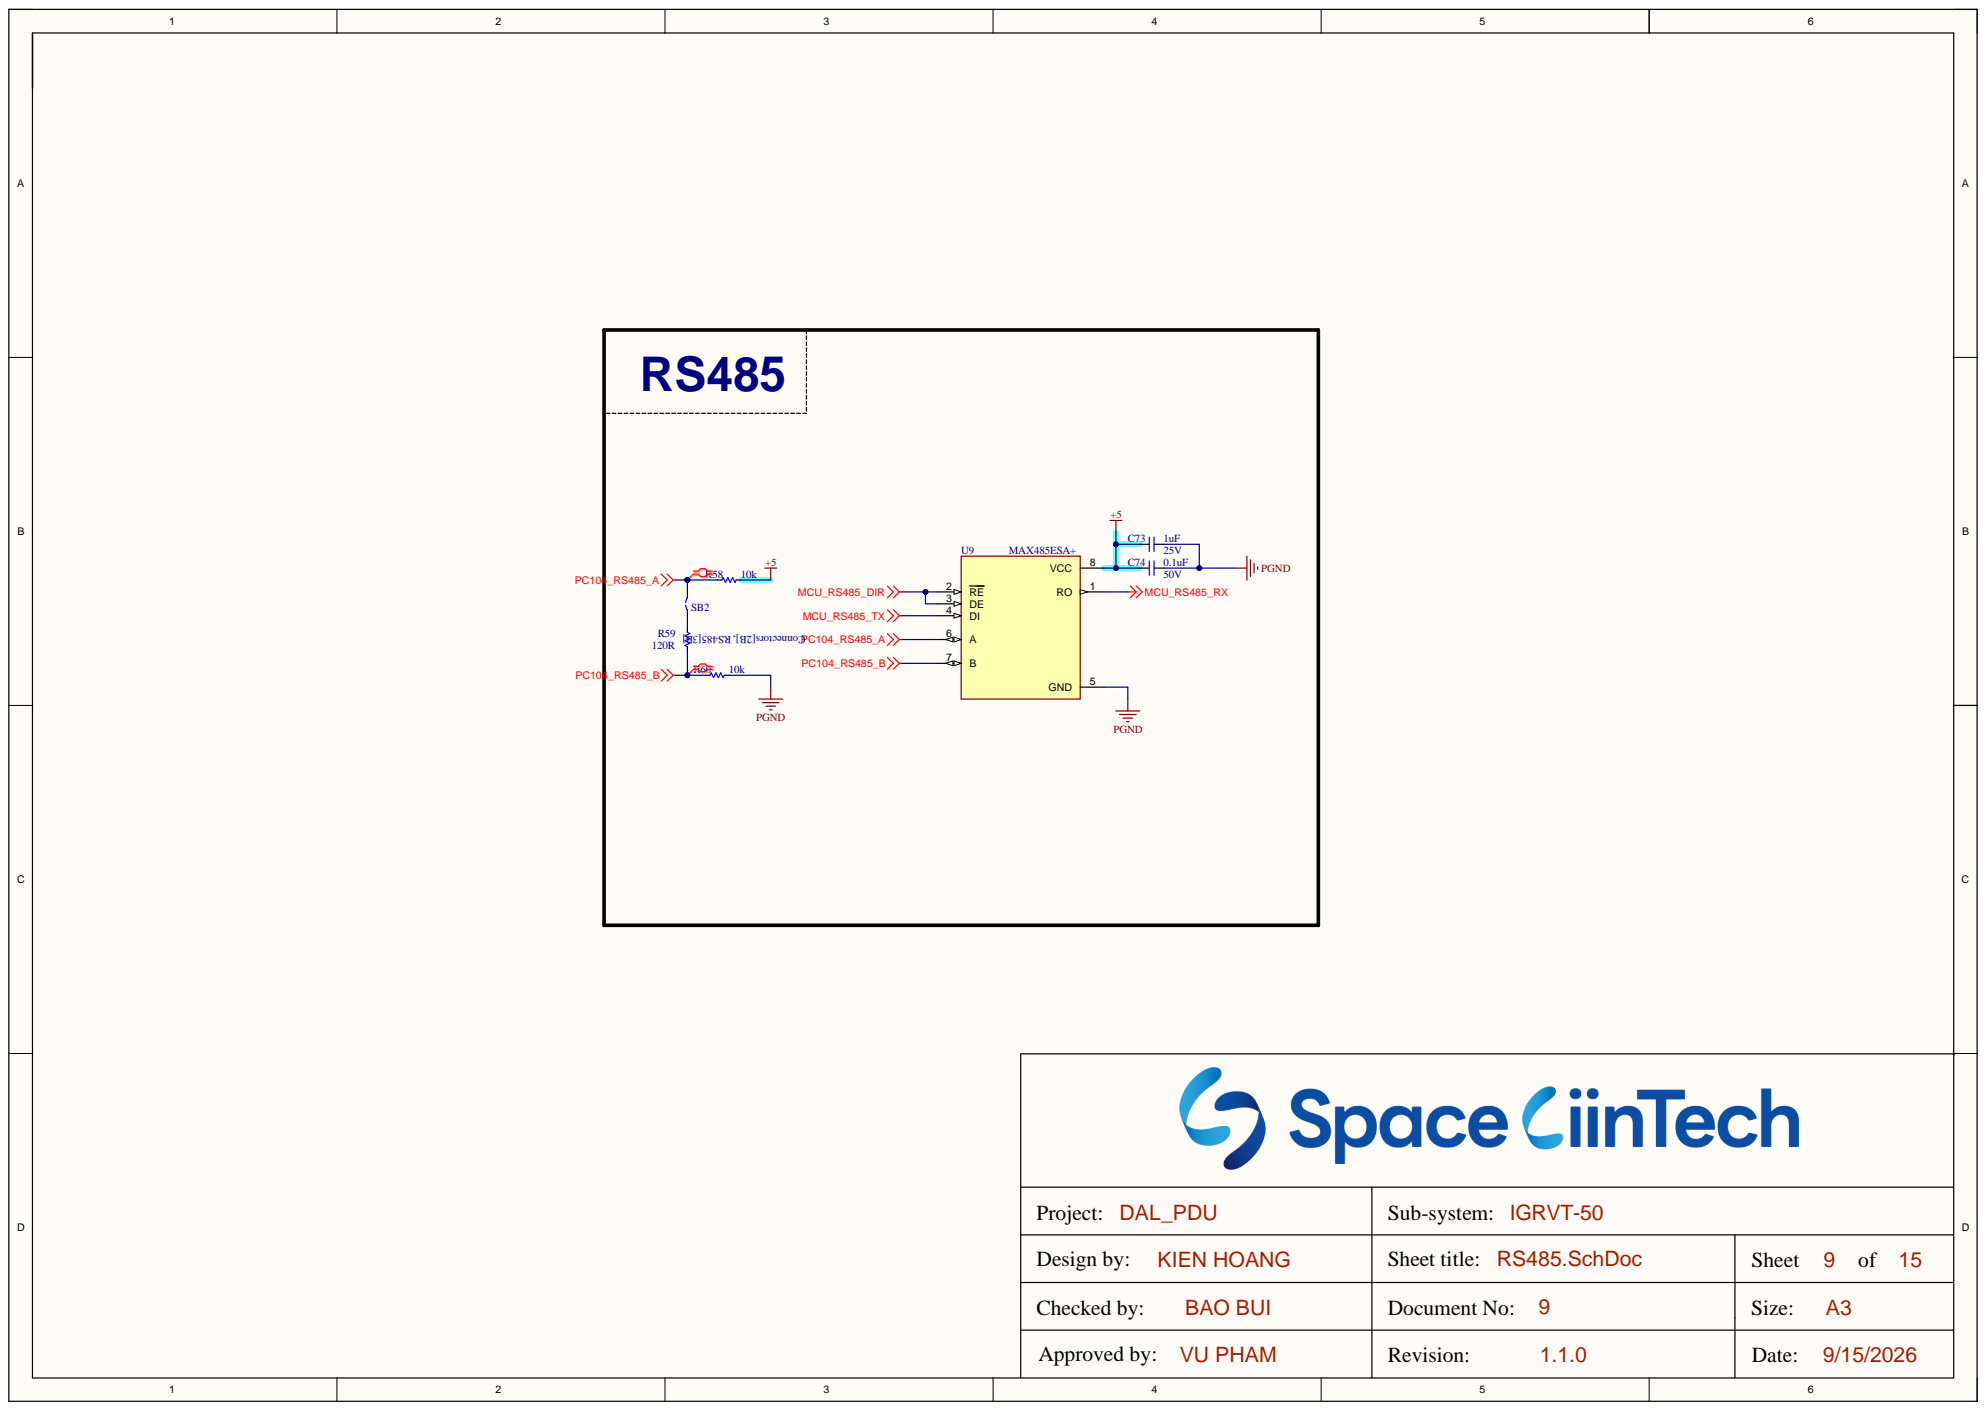
[picture p9: page 9]

Project : DAL_PDU | Sub-system : IGRVT-50

Design by: KIEN HOANG | Sheet title: RS485.SchDoc | Sheet 9 of 15

Checked by: BAO BUI | Document No: 1.1.0 9 | Size: A3

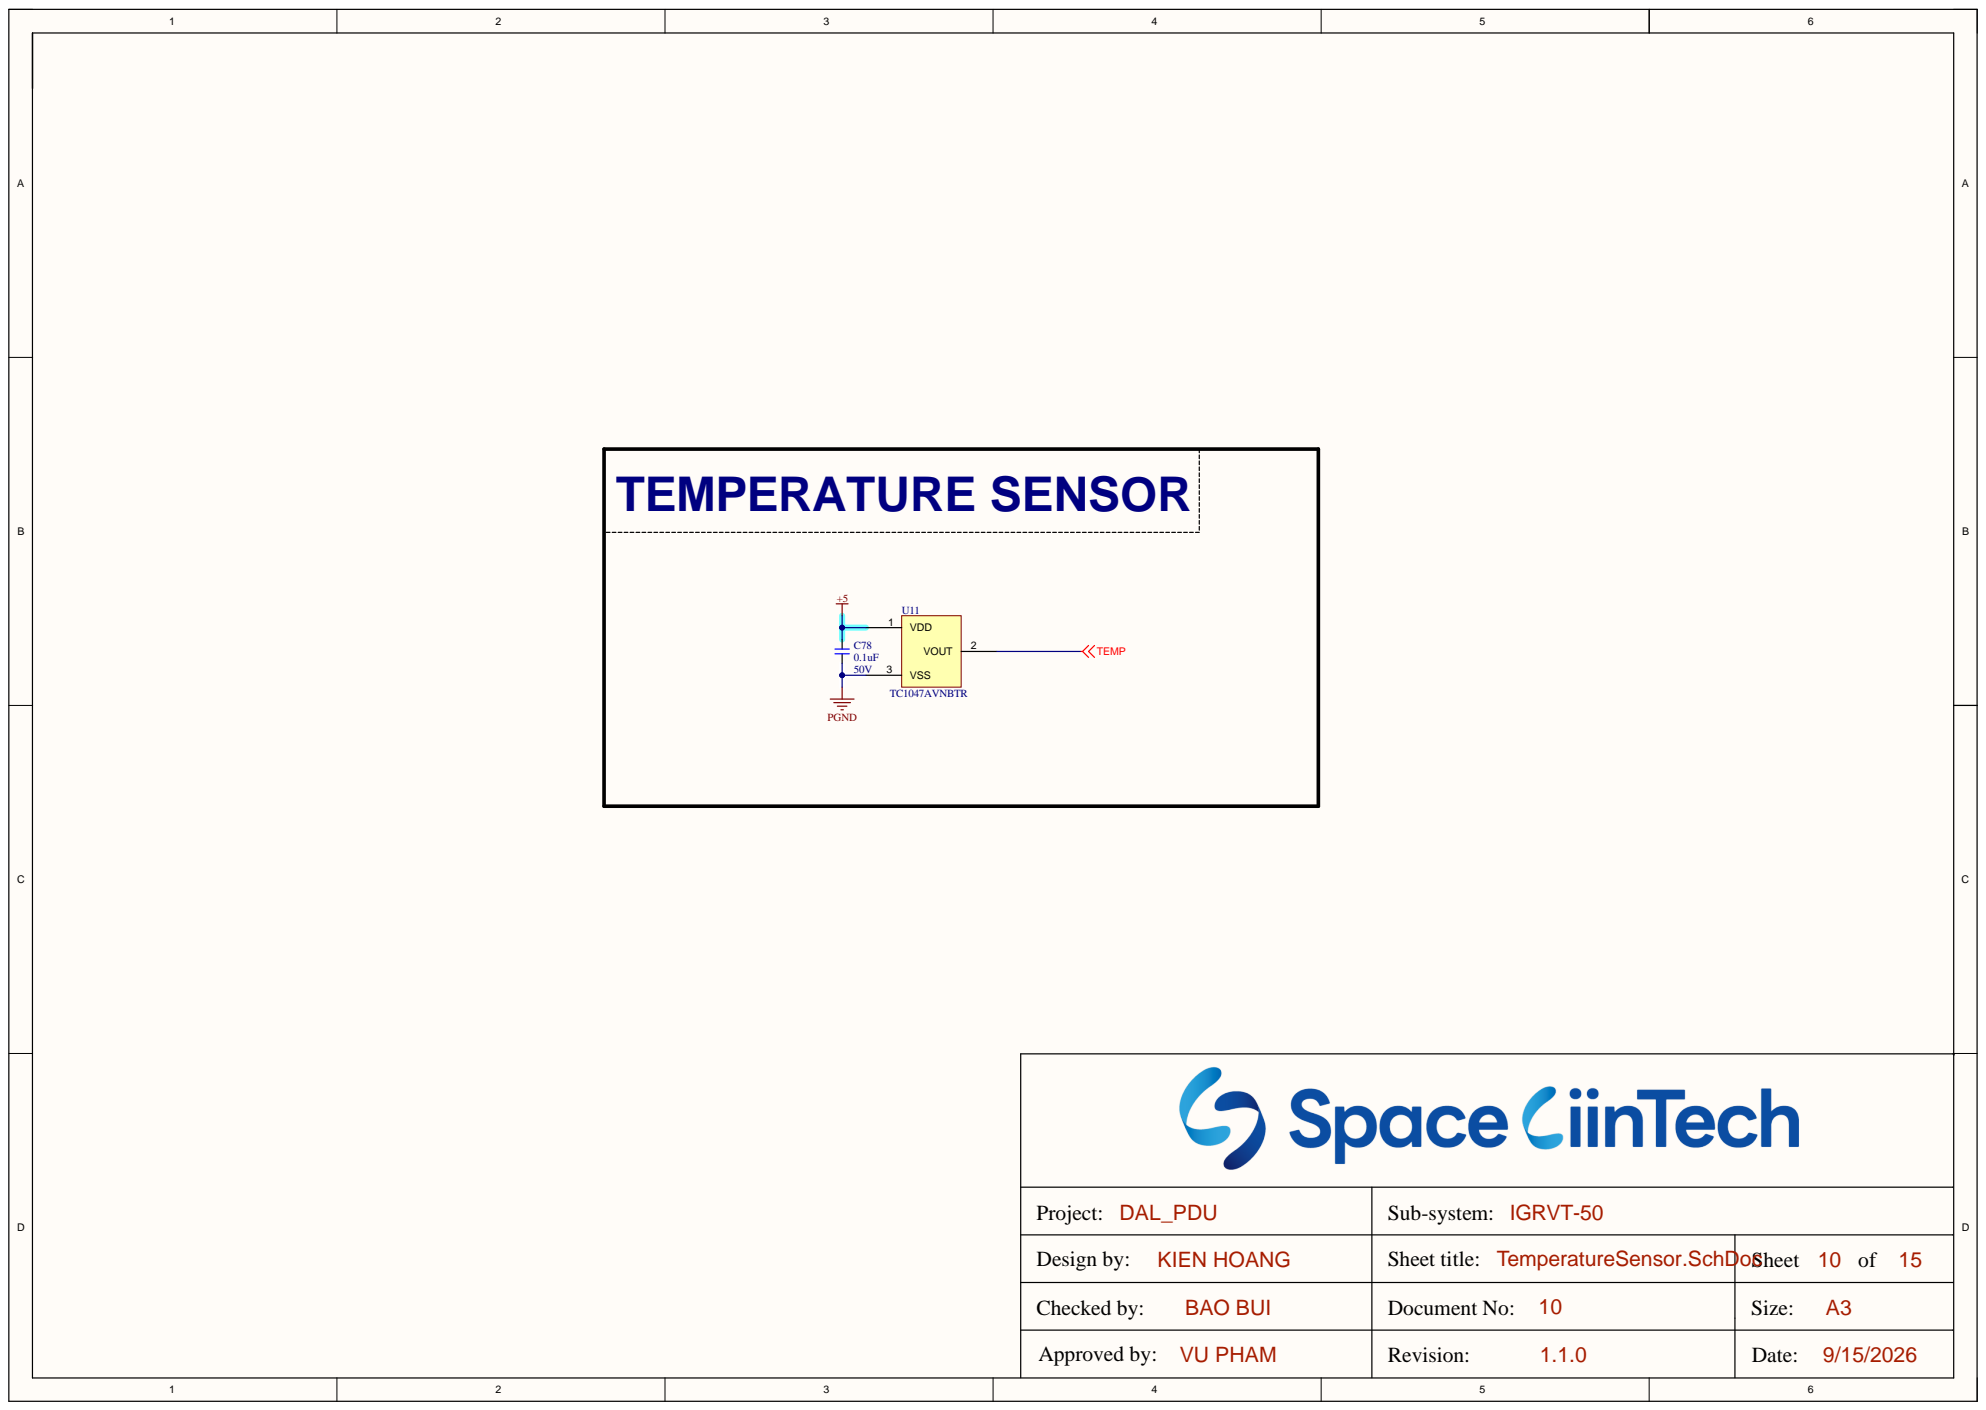
[picture p10: page 10]

Project: DAL_PDU | Sub-system: IGRVT-50

Design by: KIEN HOANG | Sheet title: TemperatureSensor.SchDoc | Sheet 10 of 15

Checked by: BAO BUI | Document No: 10 | Size: A3

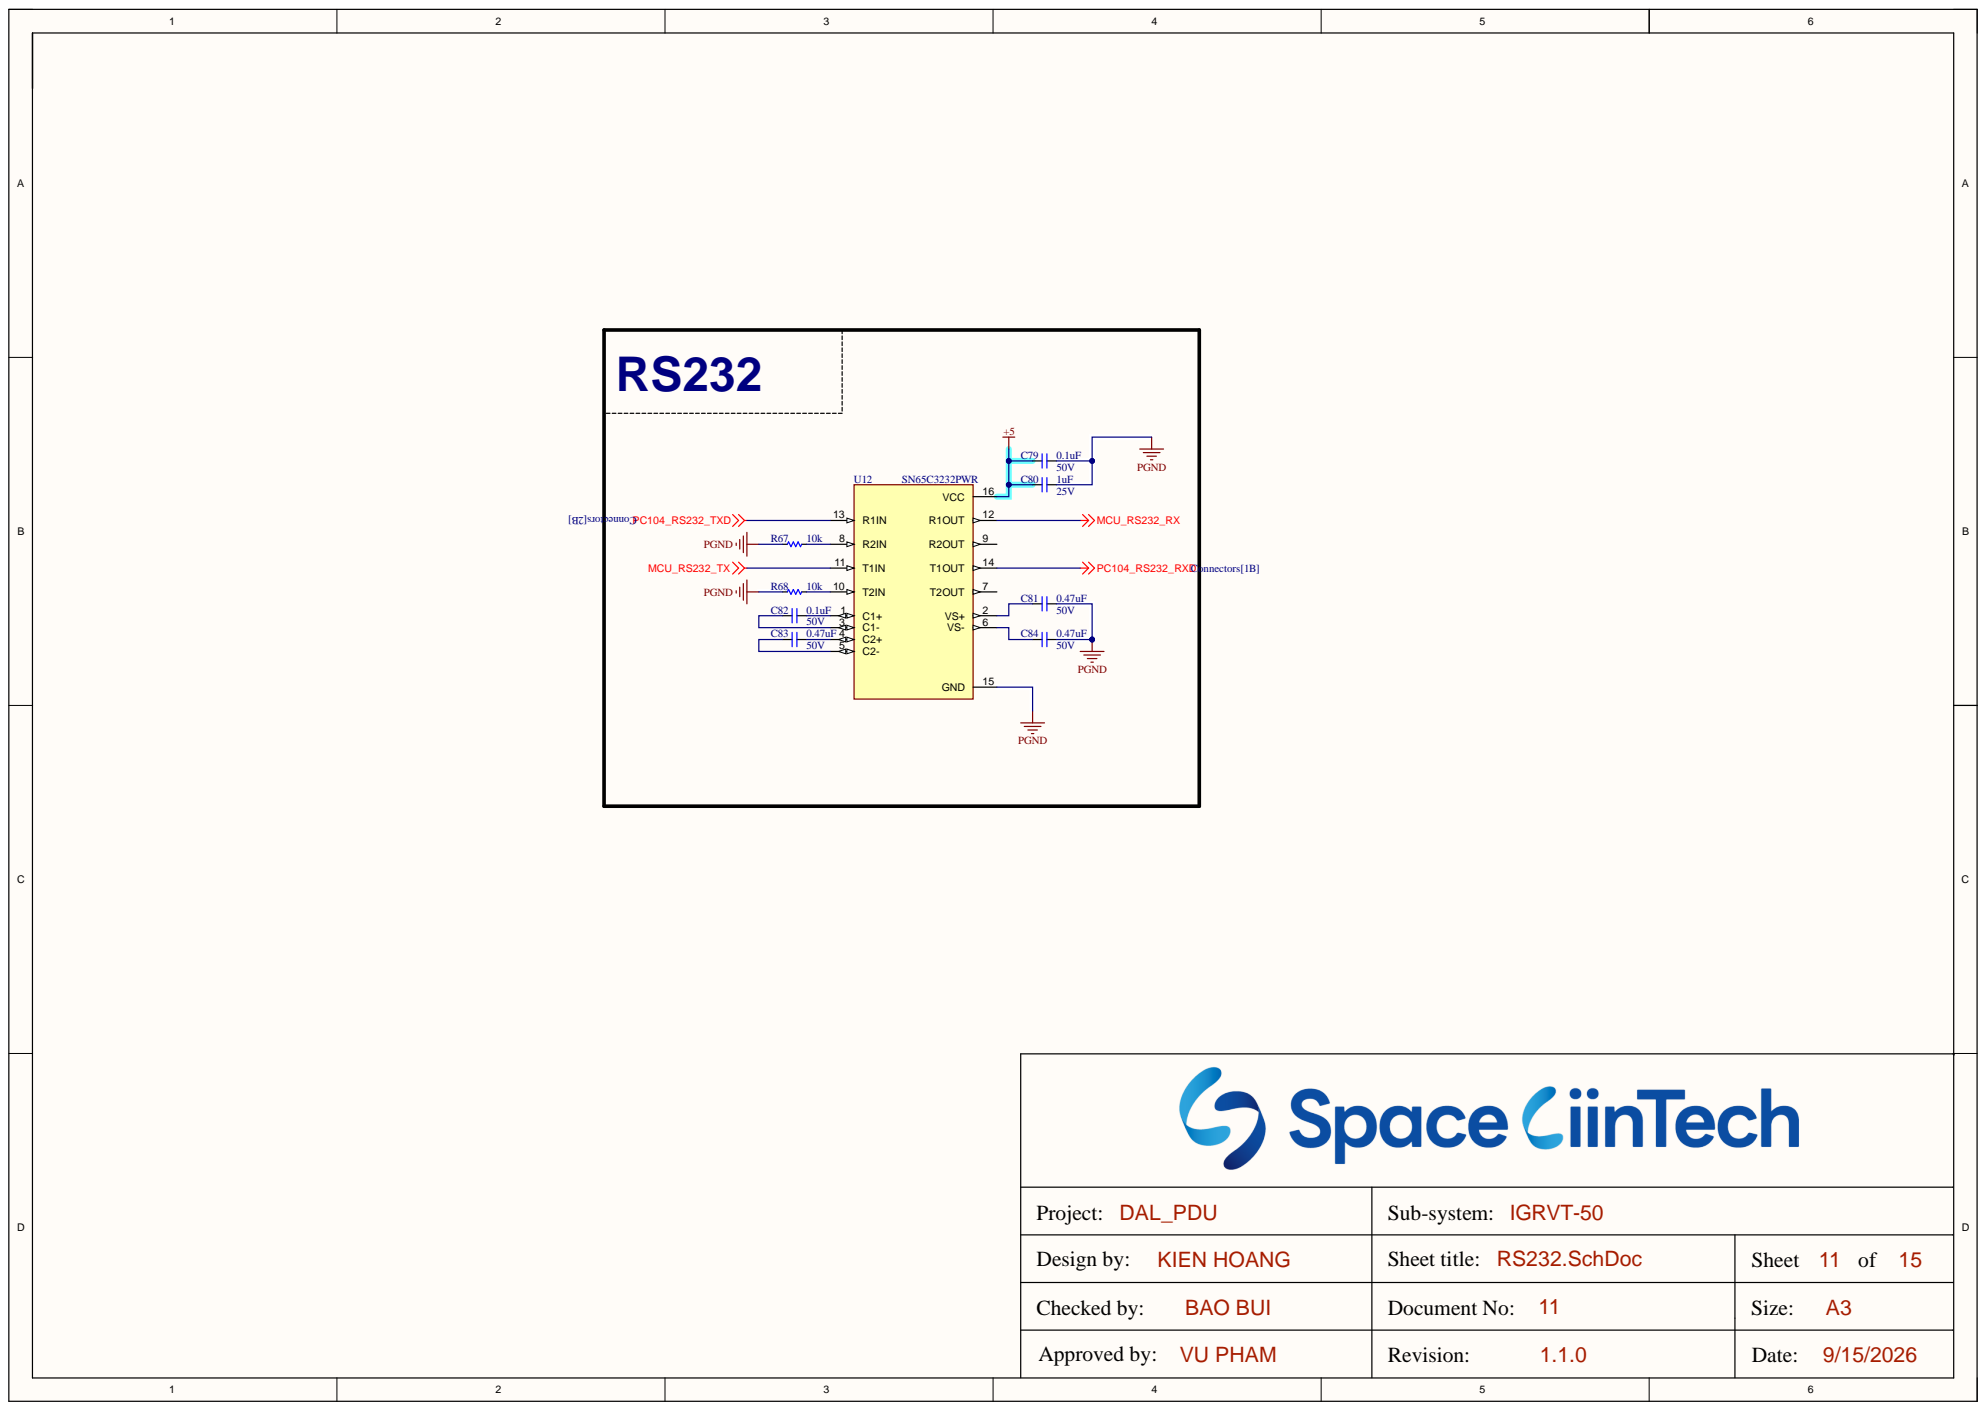
[picture p11: page 11]

Project: DAL_PDU | Sub-system: IGRVT-50

Design by: KIEN HOANG | Sheet title: RS232.SchDoc | Sheet 11 of 15

Checked by: BAO BUI | Document No: 11 | Size: A3

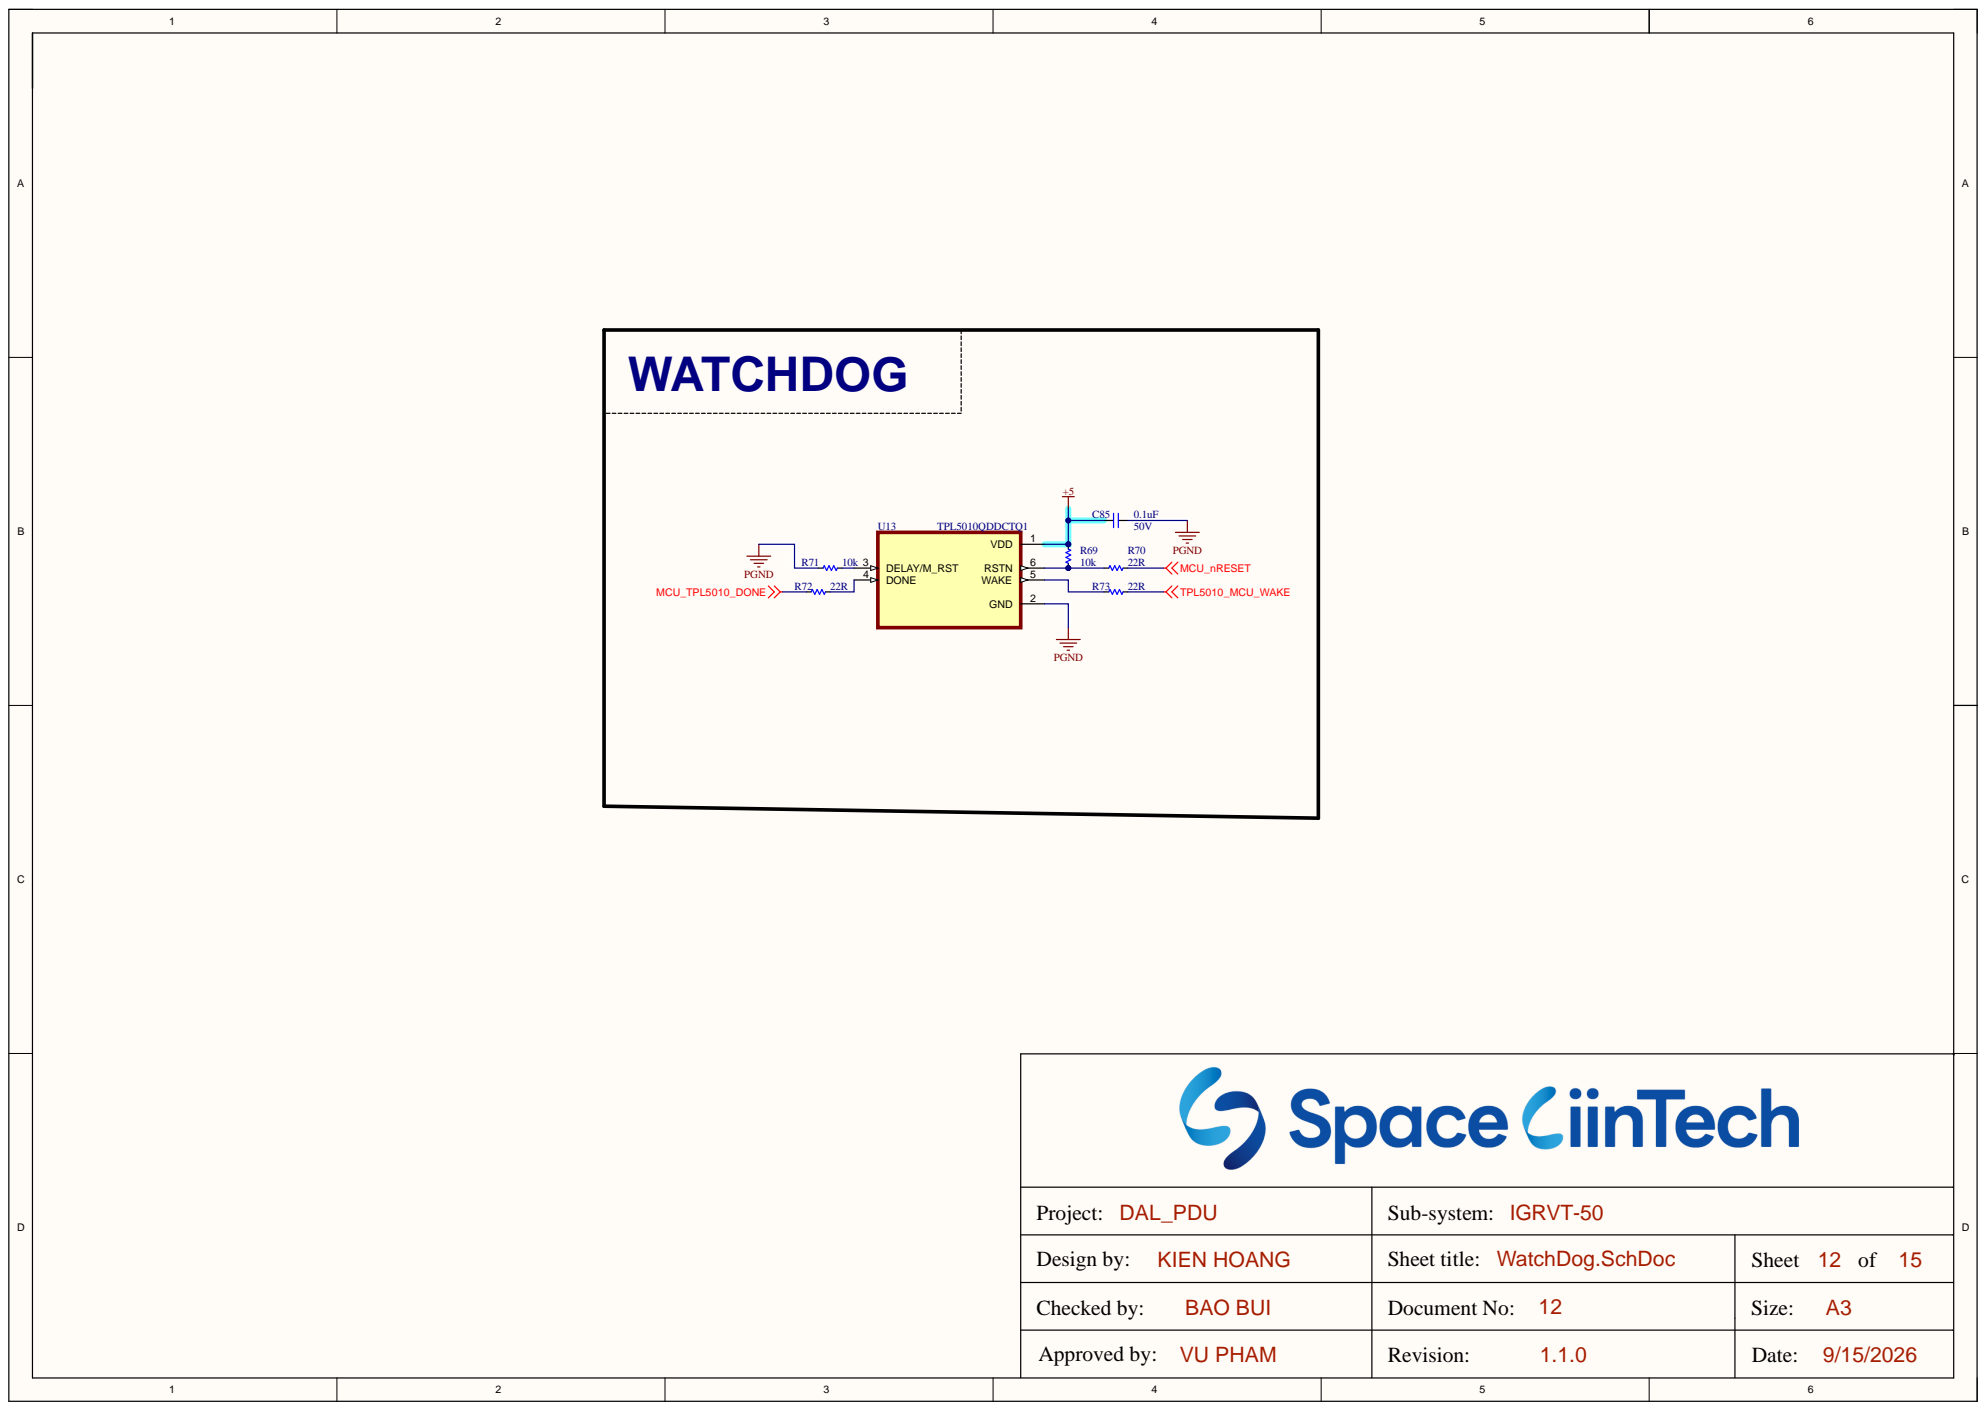
[picture p12: page 12]

Project : DAL_PDU | Sub-system : IGRVT-50

Design by: KIEN HOANG | Sheet title: WatchDog.SchDoc | Sheet 12 of 15

Checked by: BAO BUI | Document No: 12 | Size: A3

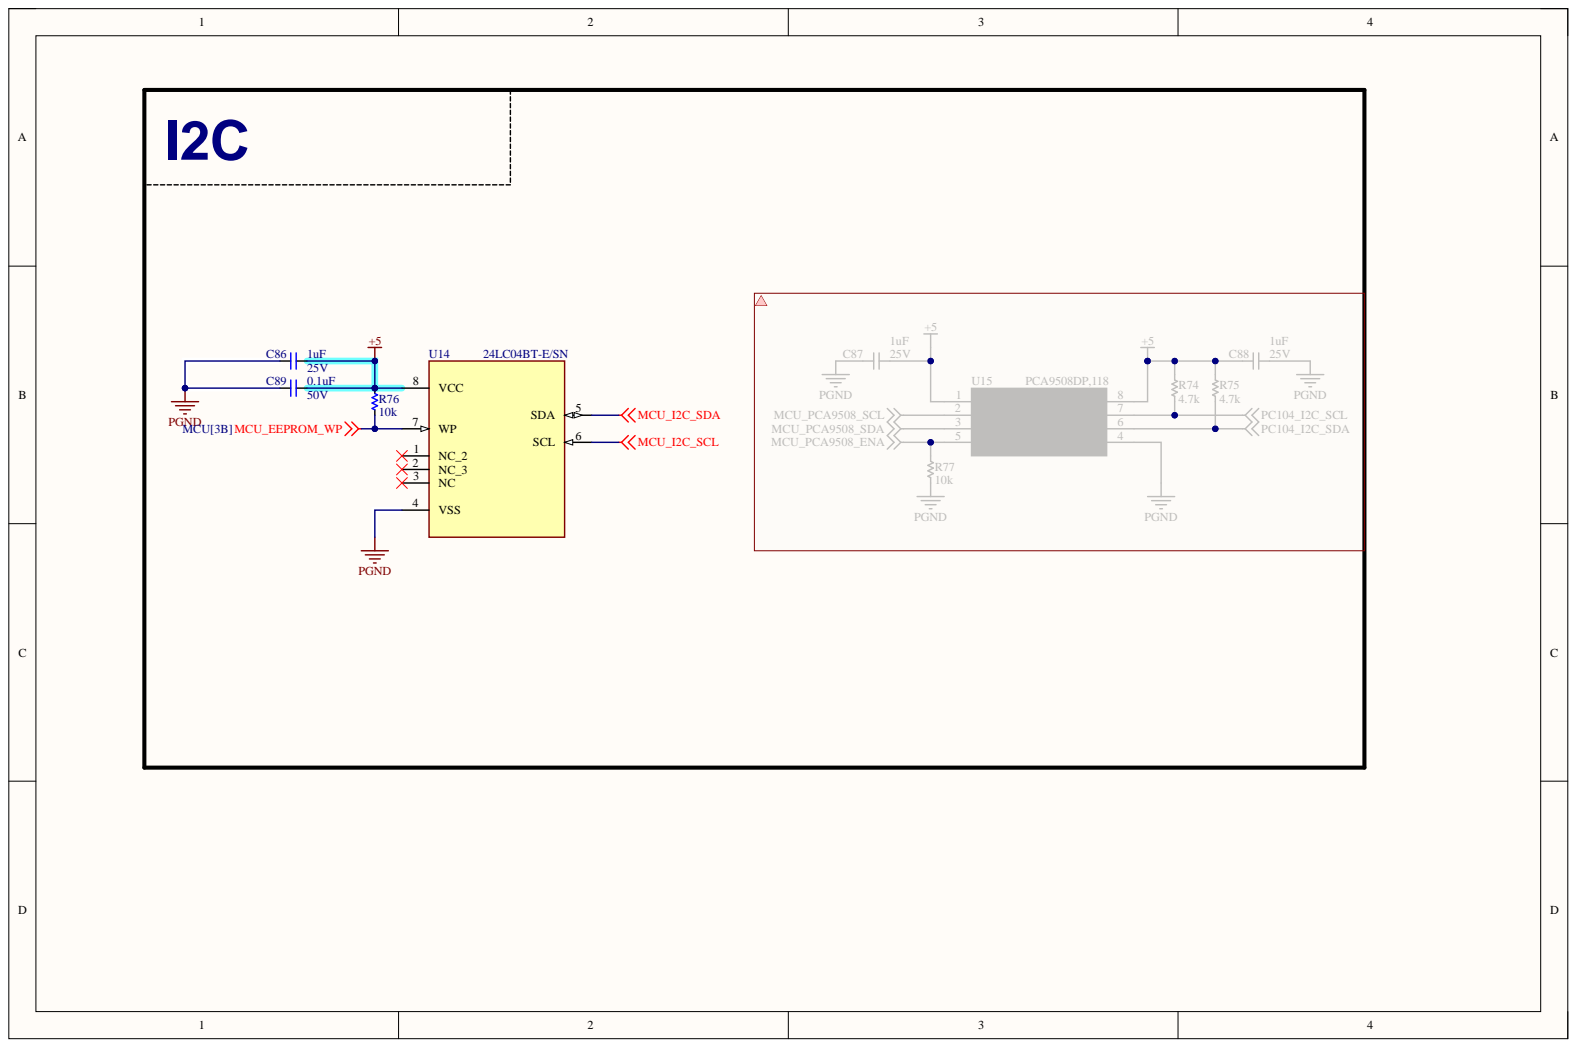
[picture p13: page 13]

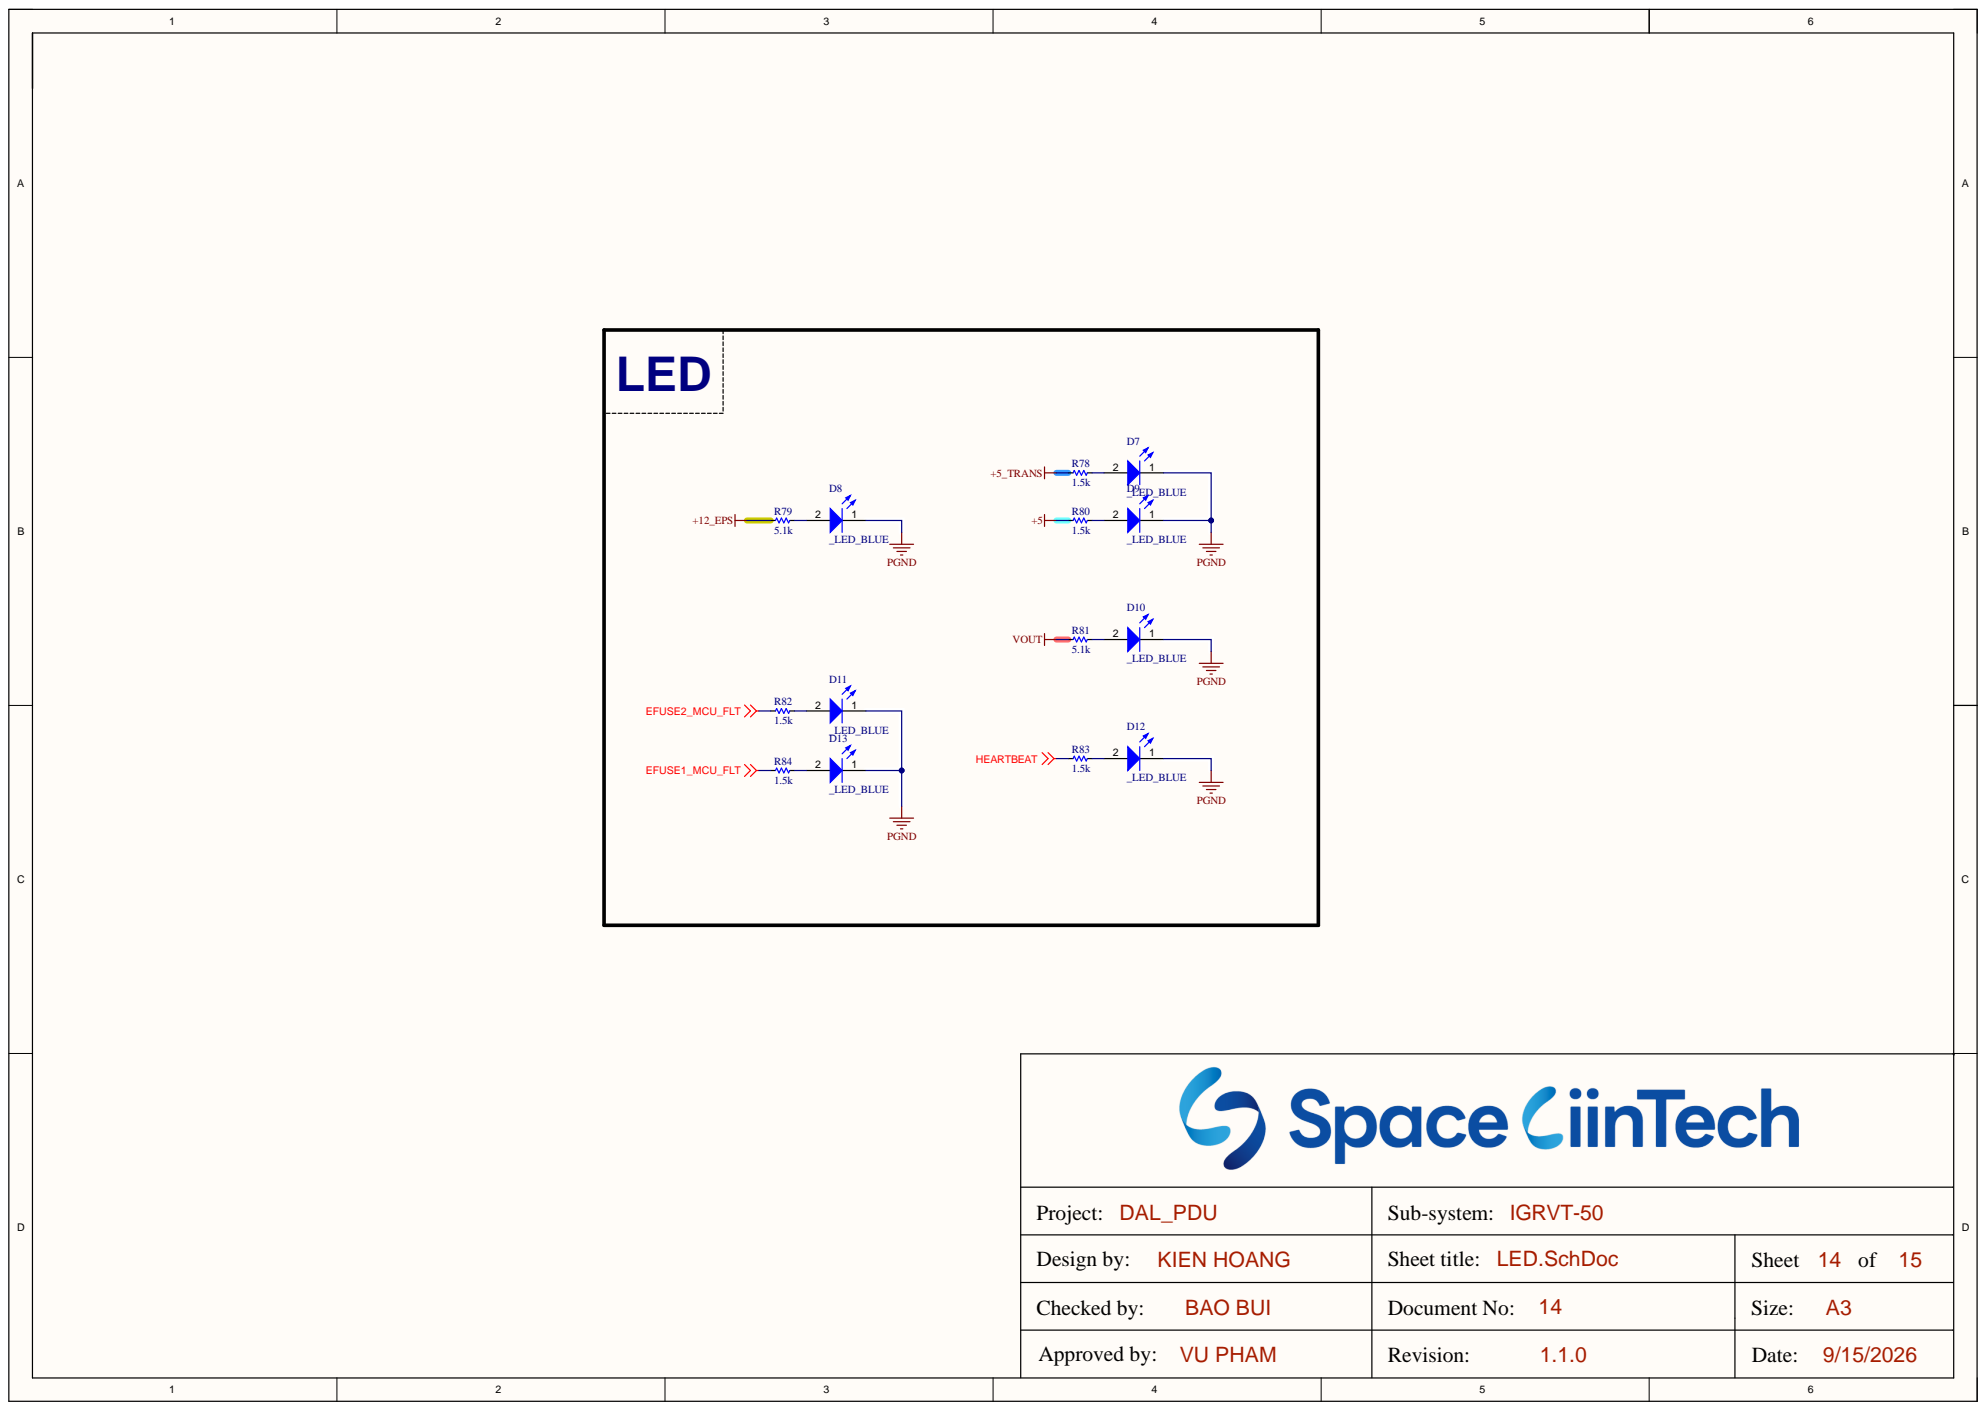
[picture p14: page 14]

Project: DAL_PDU | Sub-system: IGRVT-50

Design by: KIEN HOANG | Sheet title: LED.SchDoc | Sheet 14 of 15

Checked by: BAO BUI | Document No: 14 | Size: A3

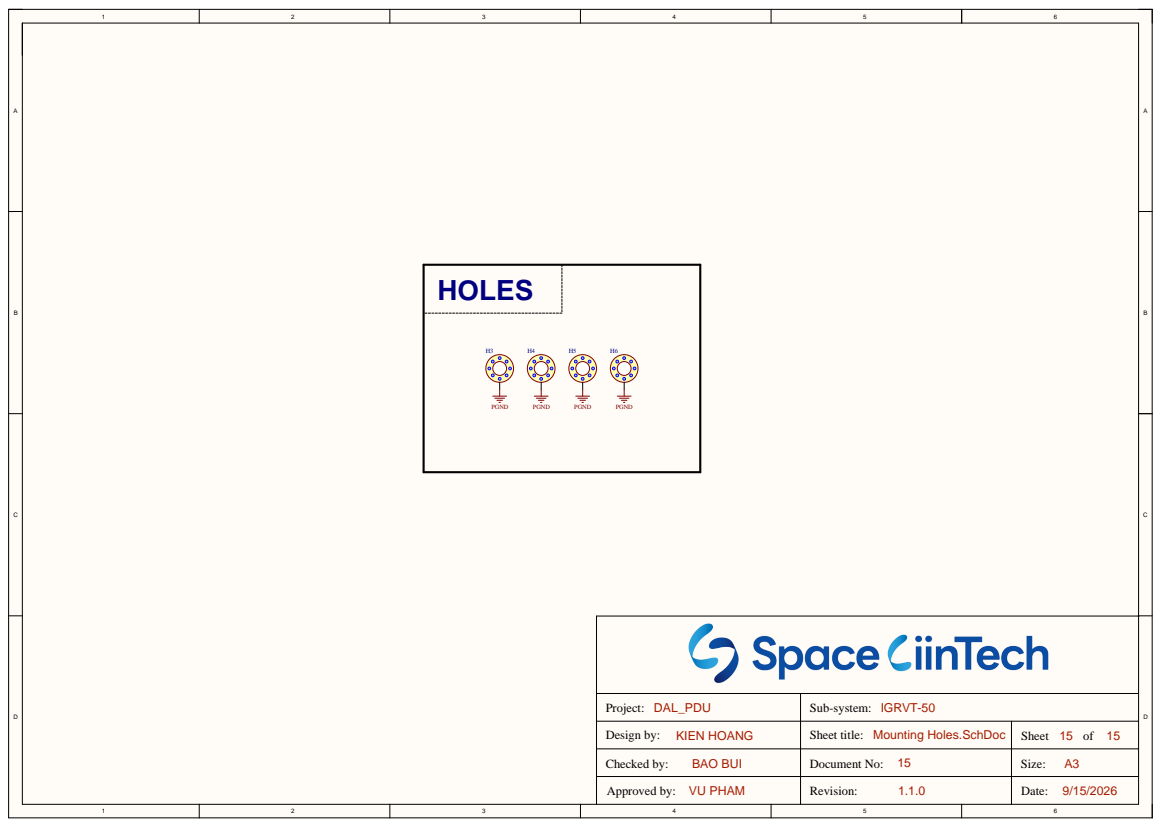
[picture p15: page 15]

Project: DAL_PDU | Sub-system: IGRVT-50

Design by: KIEN HOANG | Sheet title: Mounting Holes.SchDoc | Sheet 15 of 15

Checked by: BAO BUI | Document No: 15 | Size: A3
