ngoccamne/DAL_PDU/(list of files, drawings)

Other design files:
sim/New Project.pdsprj
sim/Project Backups/New Project [20261004, 16-37-00].pdsprj
sim/Project Backups/New Project [20261004, 16-37-20].pdsprj
sim/Project Backups/New Project [20261004, 16-51-13].pdsprj
sim/Project Backups/New Project [20261004, 16-58-00].pdsprj
sim/Project Backups/New Project [20261004, 17-04-53].pdsprj
sim/Project Backups/New Project [20261004, 21-23-13].pdsprj
sim/Project Backups/New Project [20261005, 06-26-45].pdsprj
sim/Project Backups/New Project [20261005, 16-28-02].pdsprj
sim/Project Backups/New Project [20261006, 16-31-46].pdsprj
sim/Project Backups/New Project [20261017, 07-10-32].pdsprj
