ngoccamne/DAL_PDU/firmware/DAL_PDU/DAL_PDU/src/dev/M1_Sys/CommandLine/cmdline.c

//*****************************************************************************
//
// cmdline.c - Functions to help with processing command lines.
//
// Copyright (c) 2007-2014 Texas Instruments Incorporated.  All rights reserved.
// Software License Agreement
//
// Texas Instruments (TI) is supplying this software for use solely and
// exclusively on TI's microcontroller products. The software is owned by
// TI and/or its suppliers, and is protected under applicable copyright
// laws. You may not combine this software with "viral" open-source
// software in order to form a larger program.
//
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
// This is part of revision 2.1.0.12573 of the Tiva Utility Library.
//
//*****************************************************************************

//*****************************************************************************
//
//! \addtogroup cmdline_api
//! @{
//
//*****************************************************************************

#include <stdint.h>
#include <stdbool.h>
#include <string.h>
#include "cmdline.h"
//*****************************************************************************
//
// Defines the maximum number of arguments that can be parsed.
//
//*****************************************************************************
#ifndef CMDLINE_MAX_ARGS
#define CMDLINE_MAX_ARGS        8
#endif

//*****************************************************************************
//
// An array to hold the pointers to the command line arguments.
//
//*****************************************************************************
/* Both console sessions call this parser sequentially in AppConsole_Run. */
static char *g_ppcArgv[CMDLINE_MAX_ARGS + 1];

//*****************************************************************************
//
//! Process a command line string into arguments and execute the command.
//!
//! \param pcCmdLine points to a string that contains a command line that was
//! obtained by an application by some means.
//!
//! This function will take the supplied command line string and break it up
//! into individual arguments.  The first argument is treated as a command and
//! is searched for in the command table.  If the command is found, then the
//! command function is called and all of the command line arguments are passed
//! in the normal argc, argv form.
//!
//! The command table is contained in an array named <tt>g_psCmdTable</tt>
//! containing <tt>tCmdLineEntry</tt> structures which must be provided by the
//! application.  The array must be terminated with an entry whose \b pcCmd
//! field contains a NULL pointer.
//!
//! \return Returns \b CMDLINE_BAD_CMD if the command is not found,
//! \b CMDLINE_TOO_MANY_ARGS if there are more arguments than can be parsed.
//! Otherwise it returns the code that was returned by the command function.
//
//*****************************************************************************
uint8_t CmdLineProcess(CommandContext *context, char *pcCmdLine)
{
    char *pcChar;
    uint_fast8_t ui8Argc;
    bool bFindArg = true;
    tCmdLineEntry *psCmdEntry;

    //
    // Initialize the argument counter, and point to the beginning of the
    // command line string.
    //
    ui8Argc = 0;
    pcChar = pcCmdLine;

    //
    // Advance through the command line until a zero character is found.
    //
    while(*pcChar)
    {
        //
        // If there is a space, then replace it with a zero, and set the flag
        // to search for the next argument.
        //
        if(*pcChar == ' ')
        {
            *pcChar = 0;
            bFindArg = true;
        }

        //
        // Otherwise it is not a space, so it must be a character that is part
        // of an argument.
        //
        else
        {
            //
            // If bFindArg is set, then that means we are looking for the start
            // of the next argument.
            //
            if(bFindArg)
            {
                //
                // As long as the maximum number of arguments has not been
                // reached, then save the pointer to the start of this new arg
                // in the argv array, and increment the count of args, argc.
                //
                if(ui8Argc < CMDLINE_MAX_ARGS)
                {
                    g_ppcArgv[ui8Argc] = pcChar;
                    ui8Argc++;
                    bFindArg = false;
                }

                //
                // The maximum number of arguments has been reached so return
                // the error.
                //
                else
                {
                    return(CMDLINE_TOO_MANY_ARGS);
                }
            }
        }

        //
        // Advance to the next character in the command line.
        //
        pcChar++;
    }

    //
    // If one or more arguments was found, then process the command.
    //
    if(ui8Argc)
    {
        //
        // Start at the beginning of the command table, to look for a matching
        // command.
        //
        psCmdEntry = &g_psCmdTable[0];

        //
        // Search through the command table until a null command string is
        // found, which marks the end of the table.
        //
        while(psCmdEntry->pcCmd)
        {
            //
            // If this command entry command string matches argv[0], then call
            // the function for this command, passing the command line
            // arguments.
            //
            if(CMD_TEXT_EQUAL(g_ppcArgv[0], psCmdEntry->pcCmd))
            {

                return(psCmdEntry->pfnCmd(context, ui8Argc, g_ppcArgv));
            }

            //
            // Not found, so advance to the next entry.
            //
            psCmdEntry++;
        }
    }

    //
    // Fall through to here means that no matching command was found, so return
    // an error.
    //
    return(CMDLINE_BAD_CMD);
}

//*****************************************************************************
//
// Close the Doxygen group.
//! @}
//
//*****************************************************************************
