ngoccamne/DAL_PDU/firmware/DAL_PDU/DAL_PDU/src/dev/M1_Sys/CommandLine/cmdline.h

//*****************************************************************************
//
// cmdline.h - Prototypes for command line processing functions.
//
// Copyright (c) 2007-2014 Texas Instruments Incorporated.  All rights reserved.
// Software License Agreement
//
// Texas Instruments (TI) is supplying this software for use solely and
// exclusively on TI's microcontroller products. The software is owned by
// TI and/or its suppliers, and is protected under applicable copyright
// laws. You may not combine this software with "viral" open-source
// software in order to form a larger program.
//
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
// This is part of revision 2.1.0.12573 of the Tiva Utility Library.
//
//*****************************************************************************

#ifndef __CMDLINE_H__
#define __CMDLINE_H__
#include <stdint.h>
#include "command.h"
//*****************************************************************************
//
// If building with a C++ compiler, make all of the definitions in this header
// have a C binding.
//
//*****************************************************************************
#ifdef __cplusplus
extern "C"
{
#endif

//*****************************************************************************
//
//! \addtogroup cmdline_api
//! @{
//
//*****************************************************************************
#define CMDLINE_OK        (0)
//*****************************************************************************
//
//! Defines the value that is returned if the command is not found.
//
//*****************************************************************************
#define CMDLINE_BAD_CMD         (1)

//*****************************************************************************
//
//! Defines the value that is returned if there are too many arguments.
//
//*****************************************************************************
#define CMDLINE_TOO_MANY_ARGS   (2)

//*****************************************************************************
//
//! Defines the value that is returned if there are too few arguments.
//
//*****************************************************************************
#define CMDLINE_TOO_FEW_ARGS   (3)

//*****************************************************************************
//
//! Defines the value that is returned if an argument is invalid.
//
//*****************************************************************************
#define CMDLINE_INVALID_ARG   (4)

//*****************************************************************************
//
// Command line function callback type.
//
//*****************************************************************************
typedef int (*pfnCmdLine)(CommandContext *context, int argc, char *argv[]);

//*****************************************************************************
//
//! Structure for an entry in the command list table.
//
//*****************************************************************************
#ifdef __AVR__
#include <avr/pgmspace.h>
#include <string.h>
/* On the AVR, command names and help text are kept in flash. */
typedef PGM_P CmdText;
#define CMD_TEXT_STORAGE PROGMEM
#define CMD_TEXT_EQUAL(ram, flash) (strcmp_P((ram), (flash)) == 0)
#else
#include <string.h>
typedef const char *CmdText;
#define CMD_TEXT_STORAGE
#define CMD_TEXT_EQUAL(ram, text) (strcmp((ram), (text)) == 0)
#endif

typedef struct
{
    //
    //! A pointer to a string containing the name of the command.
    //
    CmdText pcCmd;

    //
    //! A function pointer to the implementation of the command.
    //
    pfnCmdLine pfnCmd;

    //
    //! A pointer to a string of brief help text for the command.
    //
    CmdText pcHelp;
}
tCmdLineEntry;

//*****************************************************************************
//
//! This is the command table that must be provided by the application.  The
//! last element of the array must be a structure whose pcCmd field contains
//! a NULL pointer.
//
//*****************************************************************************
extern tCmdLineEntry g_psCmdTable[];

//*****************************************************************************
//
// Close the Doxygen group.
//! @}
//
//*****************************************************************************

//*****************************************************************************
//
// Prototypes for the APIs.
//
//*****************************************************************************
extern uint8_t CmdLineProcess(CommandContext *context, char *pcCmdLine);

//*****************************************************************************
//
// Mark the end of the C bindings section for C++ compilers.
//
//*****************************************************************************
#ifdef __cplusplus
}
#endif

#endif // __CMDLINE_H__
