ngoccamne/DAL_PDU/firmware/DAL_PDU/DAL_PDU/src/dev/M1_Sys/CommandLine/command_config.h

#ifndef COMMAND_CONFIG_H_
#define COMMAND_CONFIG_H_

#include "command.h"

int Cmd_config(CommandContext *context, int argc, char *argv[]);
int Cmd_config_reset(CommandContext *context, int argc, char *argv[]);

#endif /* COMMAND_CONFIG_H_ */
