ngoccamne/DAL_PDU/firmware/DAL_PDU/DAL_PDU/src/dev/M3_Driver/Component/I2C/avr_i2c.c

#include "avr_i2c.h"

#include <avr/io.h>
#include <util/twi.h>

#define I2C_WAIT_LIMIT 10000U

static bool s_timed_out;

static bool I2C_AVR_Wait(void)
{
    uint16_t remaining = I2C_WAIT_LIMIT;
    while ((TWCR & _BV(TWINT)) == 0U && remaining-- != 0U) {}
    if ((TWCR & _BV(TWINT)) != 0U) return true;
    s_timed_out = true;
    return false;
}

bool I2C_AVR_Init(uint32_t cpu_hz, uint32_t bus_hz)
{
    uint32_t divisor;
    if (bus_hz == 0U || cpu_hz / bus_hz < 16U) return false;
    divisor = (cpu_hz / bus_hz - 16U) / 2U;
    if (divisor > 255U) return false;
    TWSR &= (uint8_t)~0x03U; /* Prescaler = 1. */
    TWBR = (uint8_t)divisor;
    TWCR = _BV(TWEN);
    return true;
}

bool I2C_AVR_Start(uint8_t address_rw)
{
    uint8_t status;
    TWCR = _BV(TWINT) | _BV(TWSTA) | _BV(TWEN);
    if (!I2C_AVR_Wait()) return false;
    status = TW_STATUS;
    if (status != TW_START && status != TW_REP_START) return false;
    TWDR = address_rw;
    TWCR = _BV(TWINT) | _BV(TWEN);
    if (!I2C_AVR_Wait()) return false;
    status = TW_STATUS;
    return status == TW_MT_SLA_ACK || status == TW_MR_SLA_ACK;
}

bool I2C_AVR_Write(uint8_t value)
{
    TWDR = value;
    TWCR = _BV(TWINT) | _BV(TWEN);
    return I2C_AVR_Wait() && TW_STATUS == TW_MT_DATA_ACK;
}

bool I2C_AVR_Read(uint8_t *value, bool ack)
{
    if (value == 0) return false;
    TWCR = _BV(TWINT) | _BV(TWEN) | (ack ? _BV(TWEA) : 0U);
    if (!I2C_AVR_Wait() || TW_STATUS != (ack ? TW_MR_DATA_ACK : TW_MR_DATA_NACK)) return false;
    *value = TWDR;
    return true;
}

void I2C_AVR_Stop(void)
{
    TWCR = _BV(TWINT) | _BV(TWSTO) | _BV(TWEN);
}

void I2C_AVR_ClearTimeout(void)
{
    s_timed_out = false;
}

bool I2C_AVR_TimedOut(void)
{
    return s_timed_out;
}

void I2C_AVR_Recover(void)
{
    TWCR = 0U;
    TWCR = _BV(TWEN);
}
